nnikolov3/ECE411/Layout and Schematics/Layout/ECE_411_project_B.png

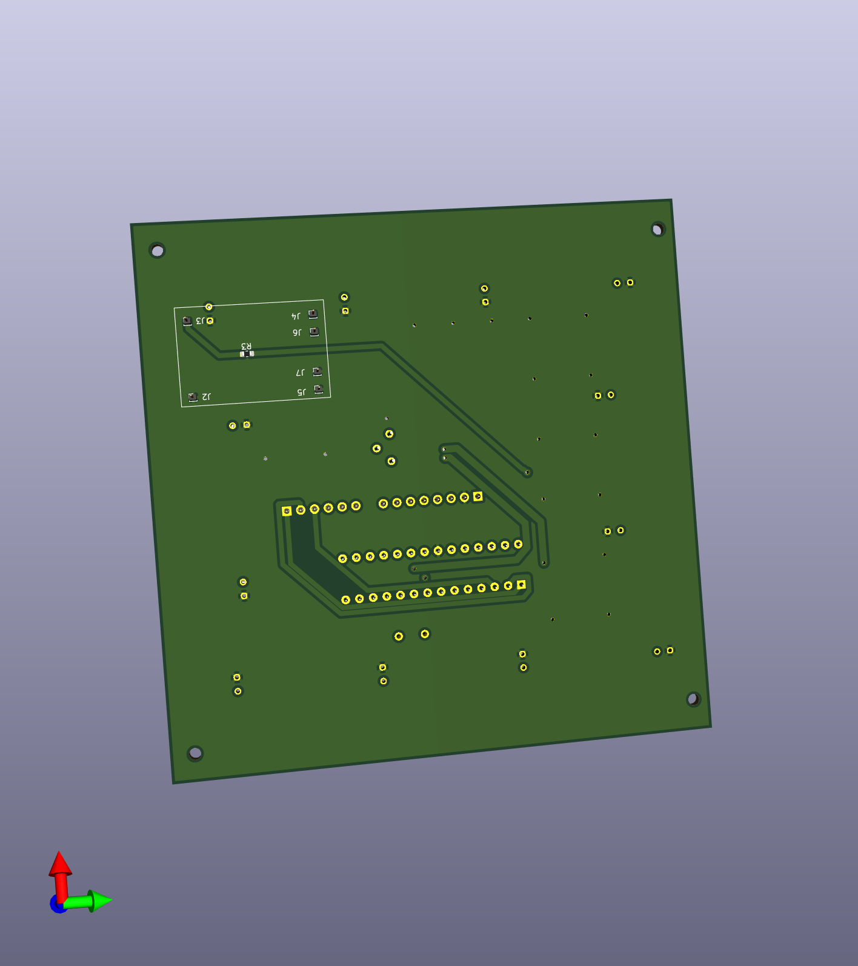
Layout and Schematics/Layout/ECE_411_project_B.png
