nnikolov3/ECE411/Pictures_and_Videos/testing_illumination/test_brightness.jpg

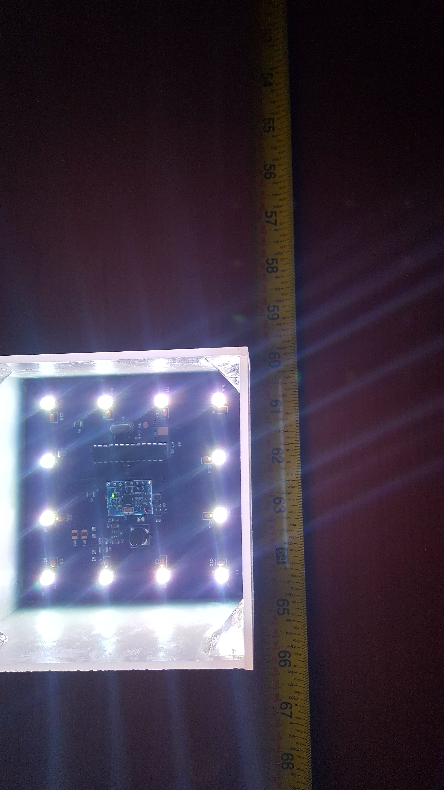
Pictures_and_Videos/testing_illumination/test_brightness.jpg
