nnikolov3/ECE411/Layout and Schematics/Layout/DRC_APPROVED_errors.png

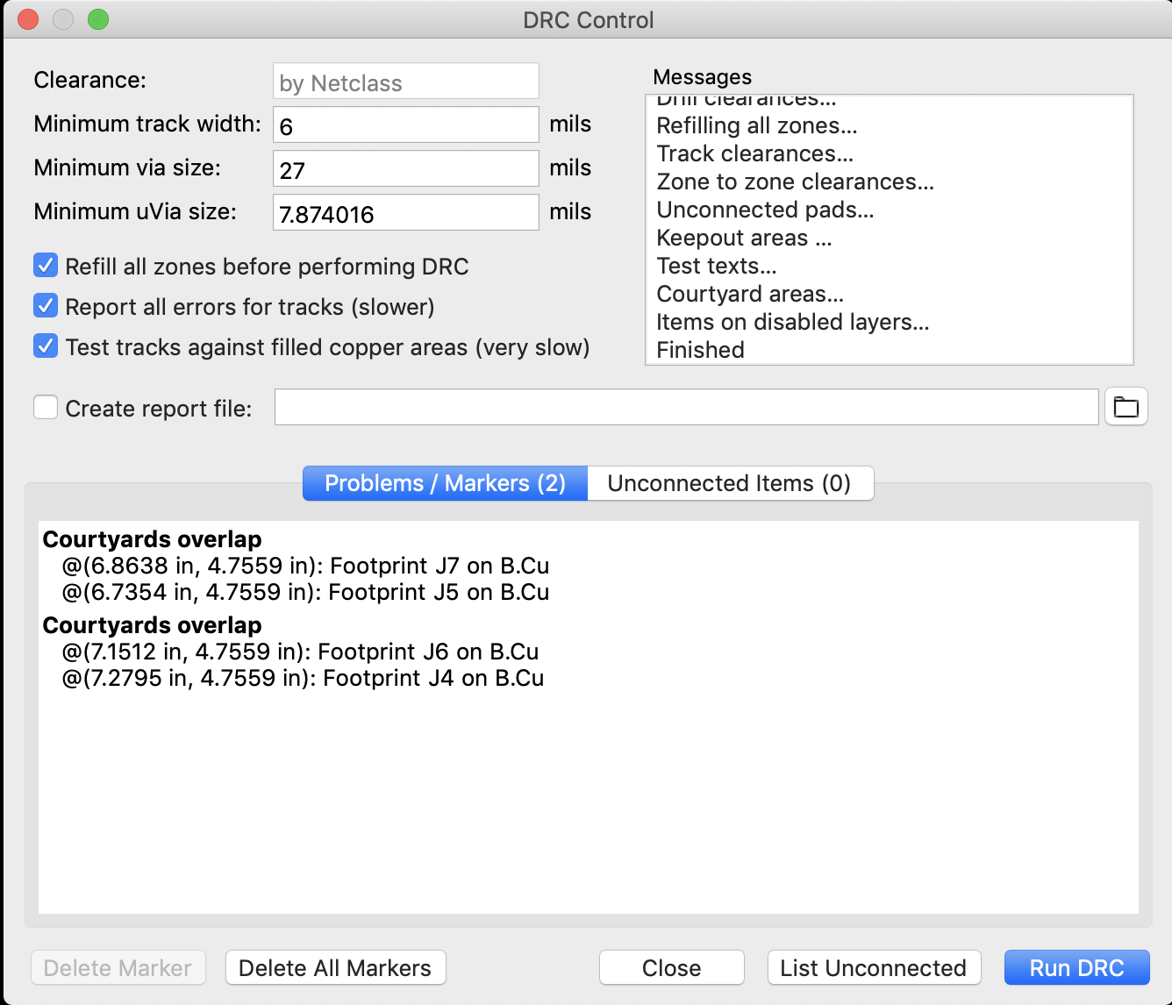
Layout and Schematics/Layout/DRC_APPROVED_errors.png
