nnikolov3/ECE411/Layout and Schematics/Layout/DRC_CLEARED.png

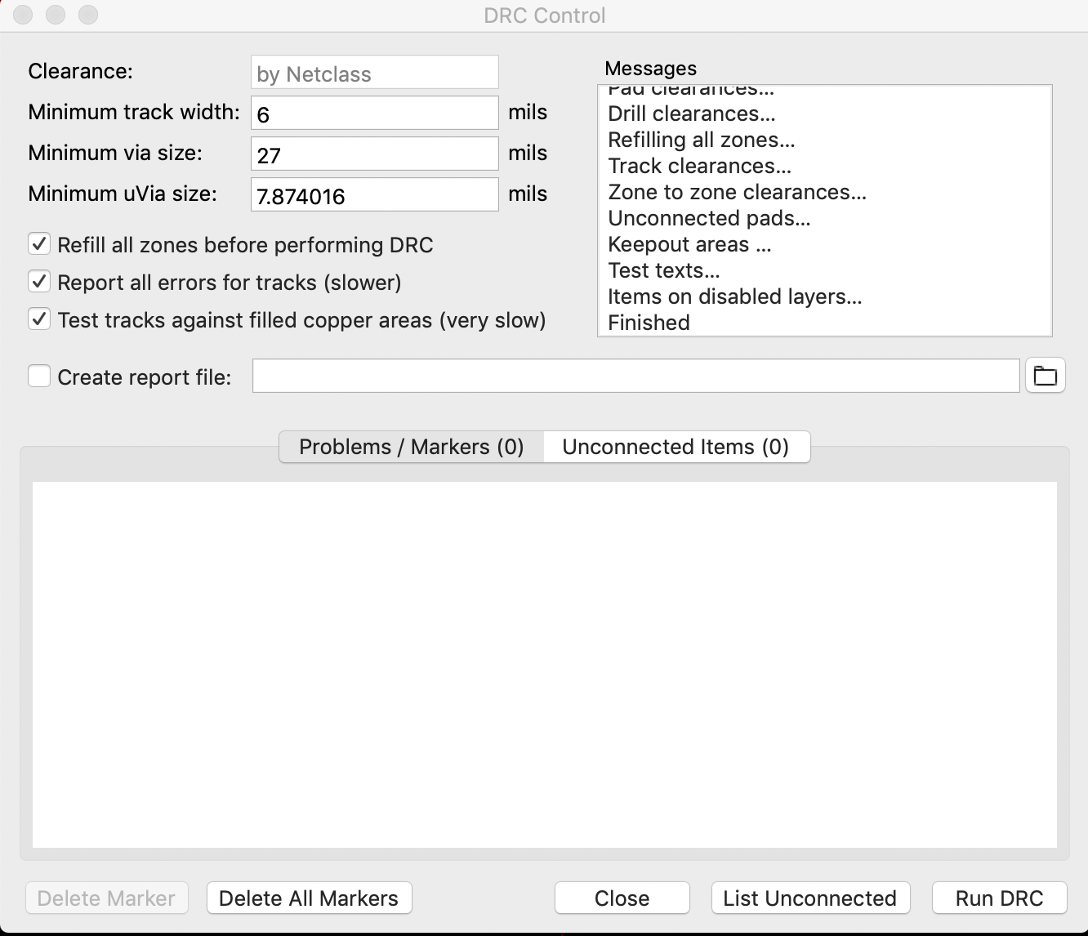
Layout and Schematics/Layout/DRC_CLEARED.png
