nnikolov3/ECE411/Layout and Schematics/Layout/ECE_411_project 2.png

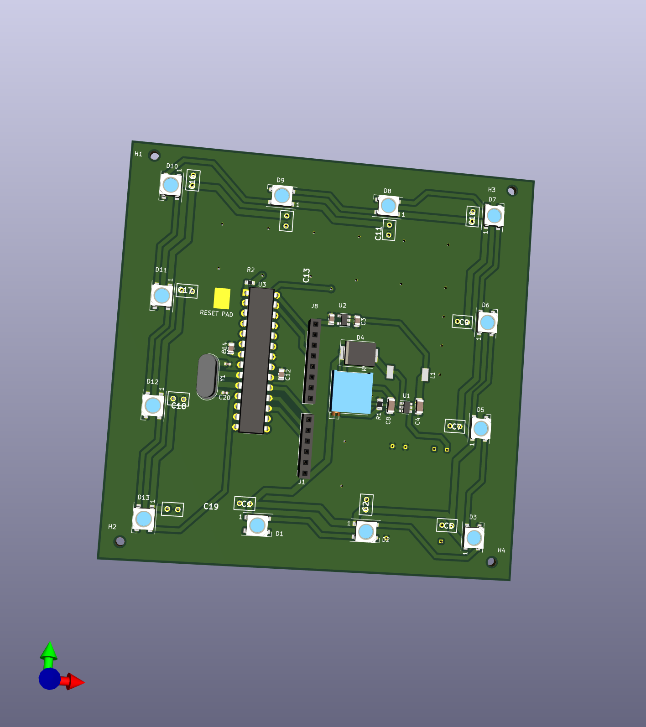
Layout and Schematics/Layout/ECE_411_project 2.png
