nnikolov3/ECE411/Layout and Schematics/Layout/ECE_411_project_3d_front.jpg

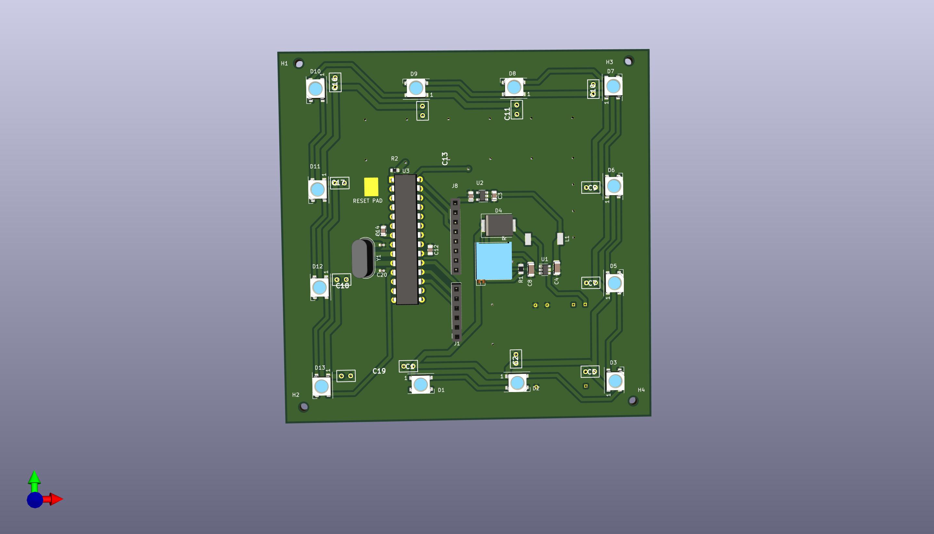
Layout and Schematics/Layout/ECE_411_project_3d_front.jpg
