nnikolov3/ECE411/Layout and Schematics/Layout/ERC_APPROVED_warning.png

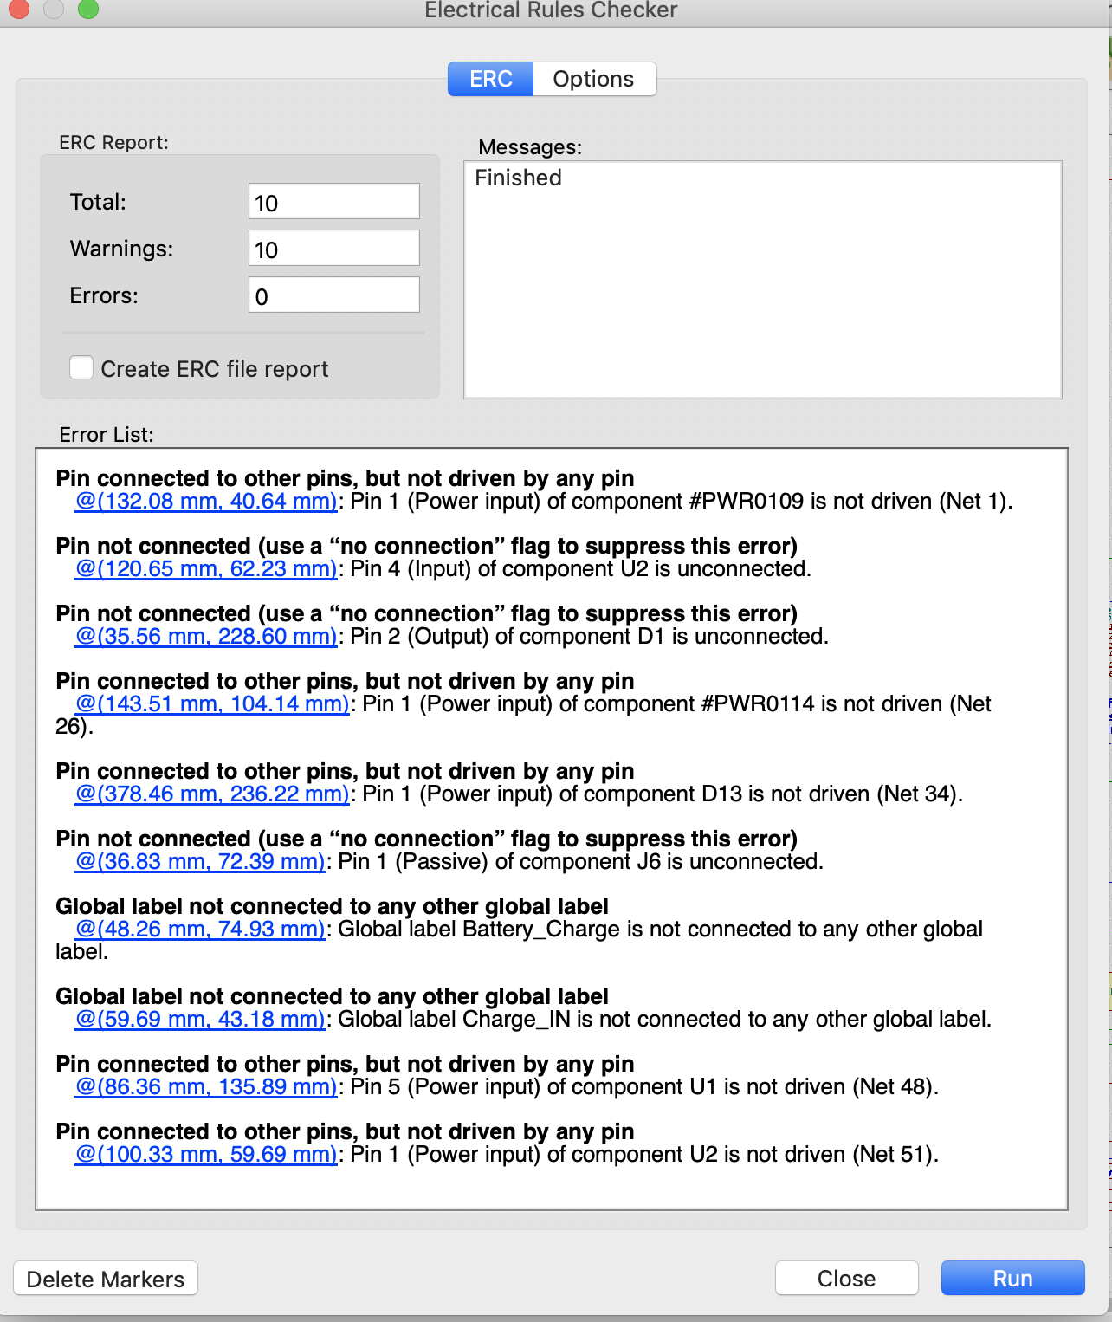
Layout and Schematics/Layout/ERC_APPROVED_warning.png
