nnikolov3/ECE411/Layout and Schematics/Schematics/ECE_411_project.png

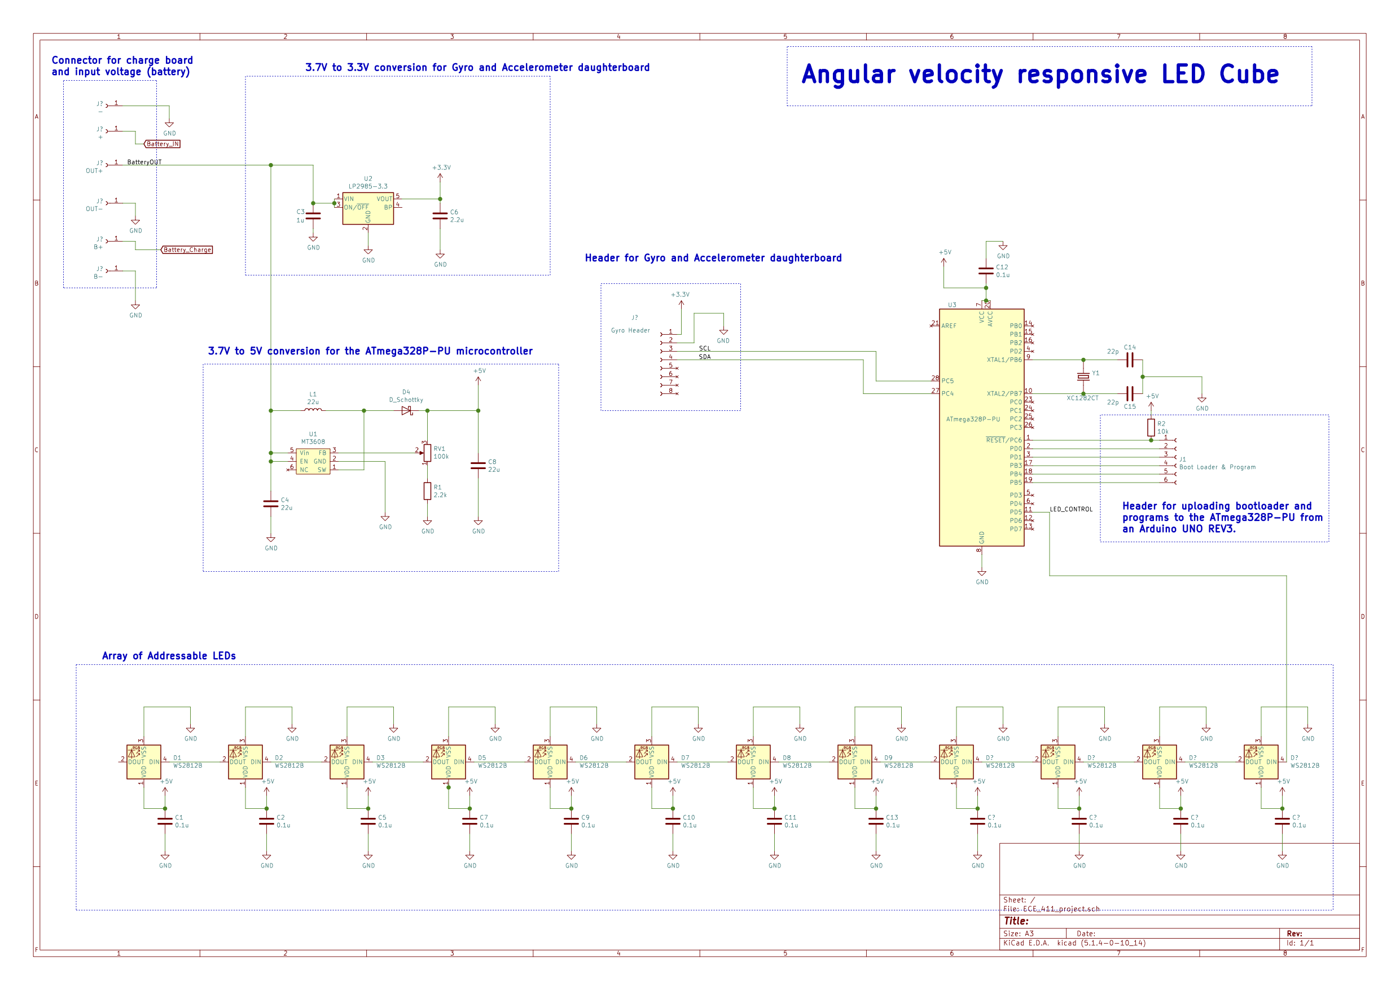
Layout and Schematics/Schematics/ECE_411_project.png
