nnikolov3/ECE411/Mechanical/charge stand bottom view.png

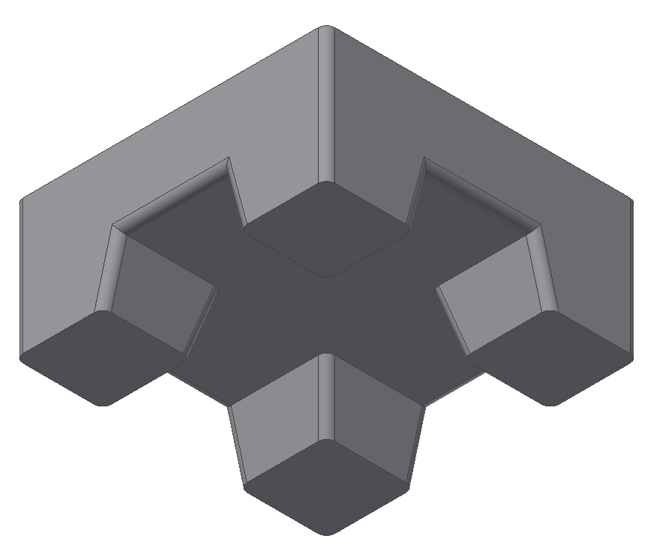
Mechanical/charge stand bottom view.png
