nnikolov3/ECE411/Mechanical/charge stand top view.png

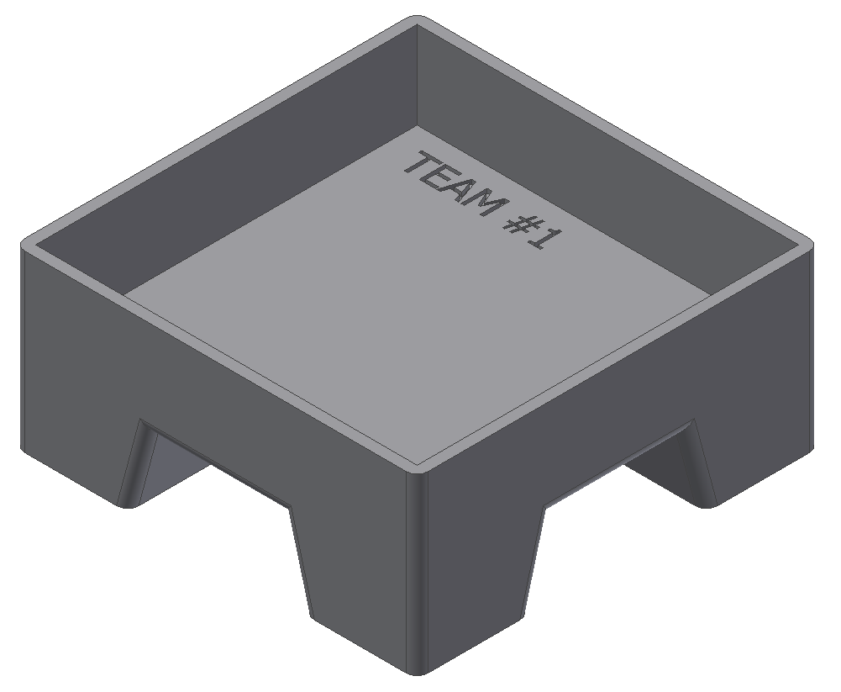
Mechanical/charge stand top view.png
