nnikolov3/ECE411/Mechanical/cube charging station.png

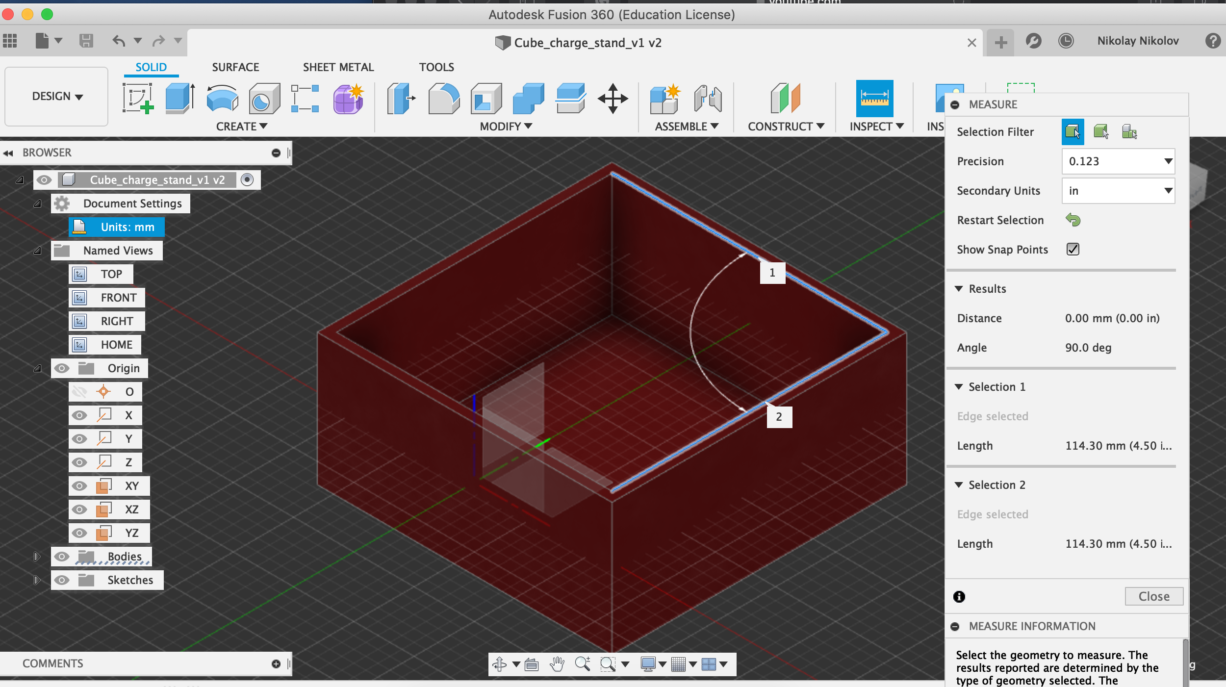
Mechanical/cube charging station.png
