nnikolov3/ECE411/Pictures_and_Videos/20191021_190228.jpg

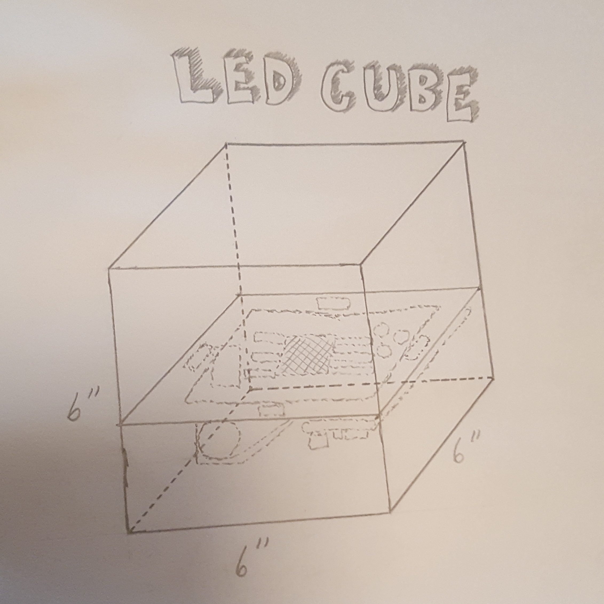
Pictures_and_Videos/20191021_190228.jpg
