nnikolov3/ECE411/Pictures_and_Videos/20191021_190235.jpg

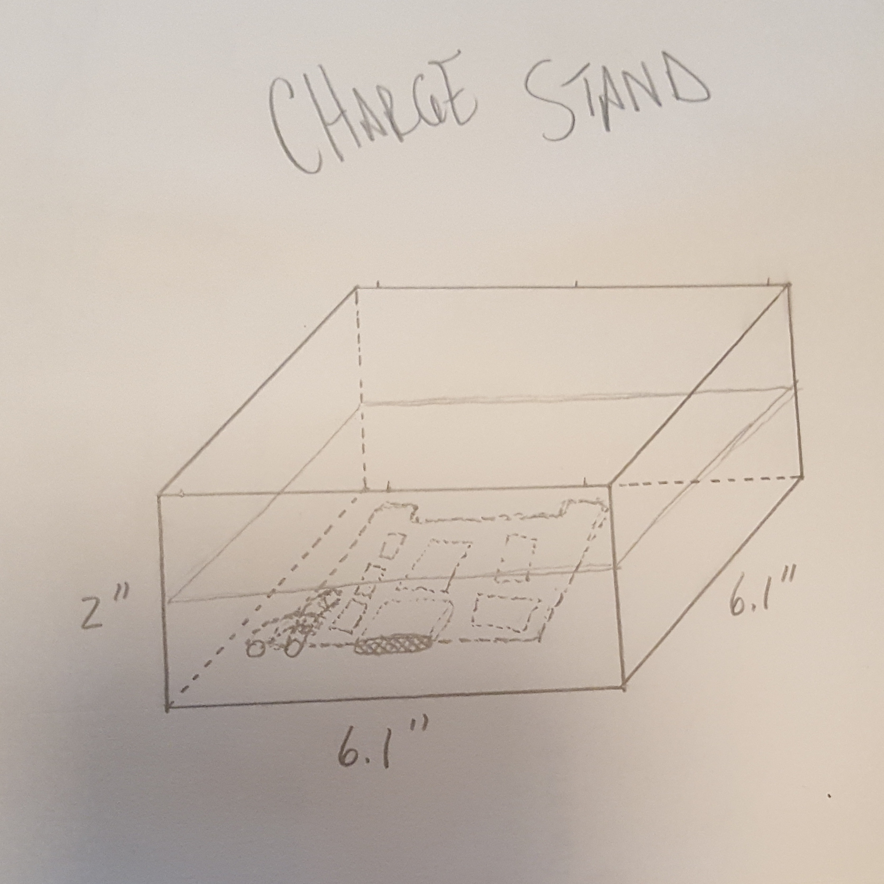
Pictures_and_Videos/20191021_190235.jpg
