nnikolov3/ECE411/Pictures_and_Videos/20191030_160920.jpg

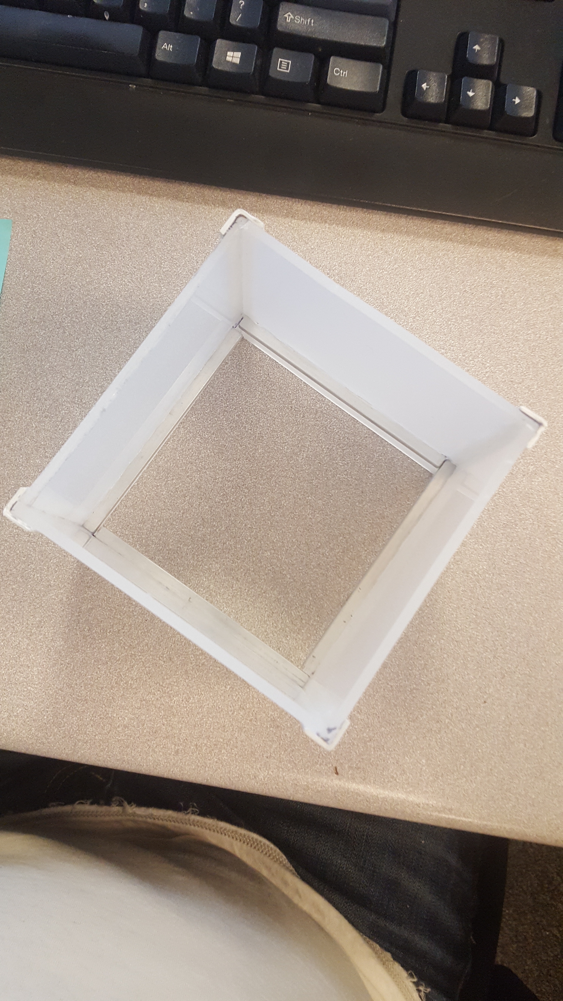
Pictures_and_Videos/20191030_160920.jpg
