nnikolov3/ECE411/Pictures_and_Videos/20191030_161455.jpg

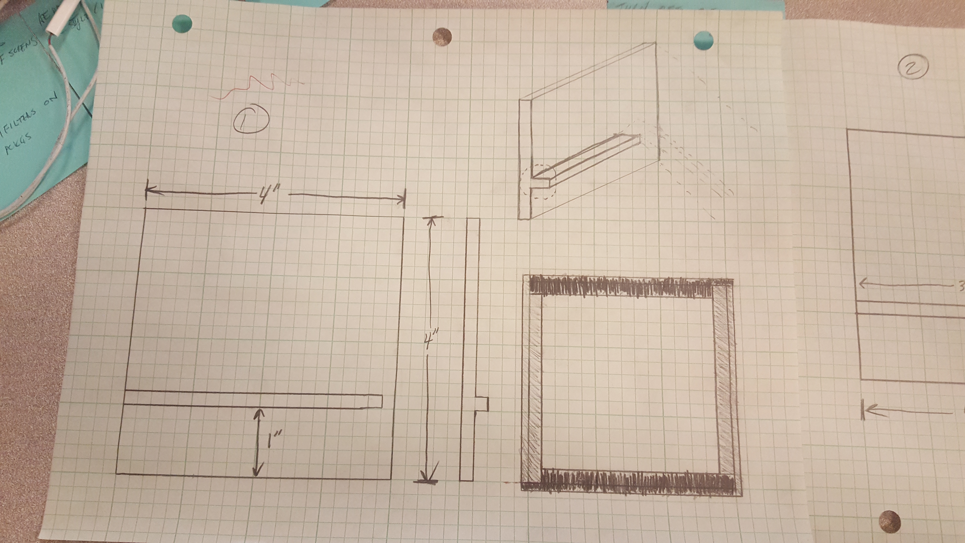
Pictures_and_Videos/20191030_161455.jpg
