nnikolov3/ECE411/Pictures_and_Videos/20191030_161500.jpg

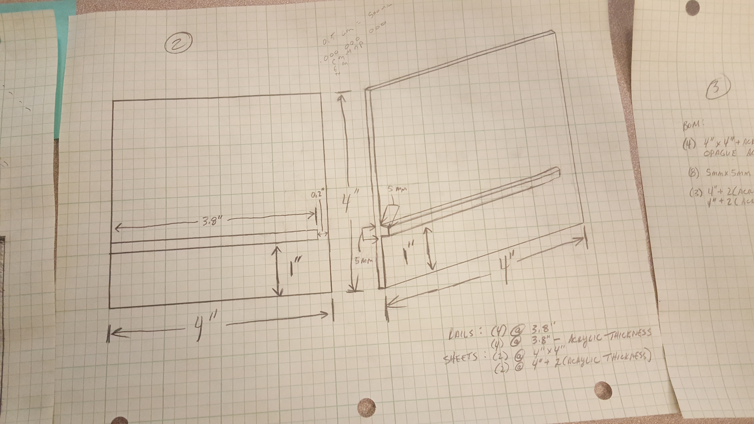
Pictures_and_Videos/20191030_161500.jpg
