nnikolov3/ECE411/Pictures_and_Videos/20191105_185958.jpg

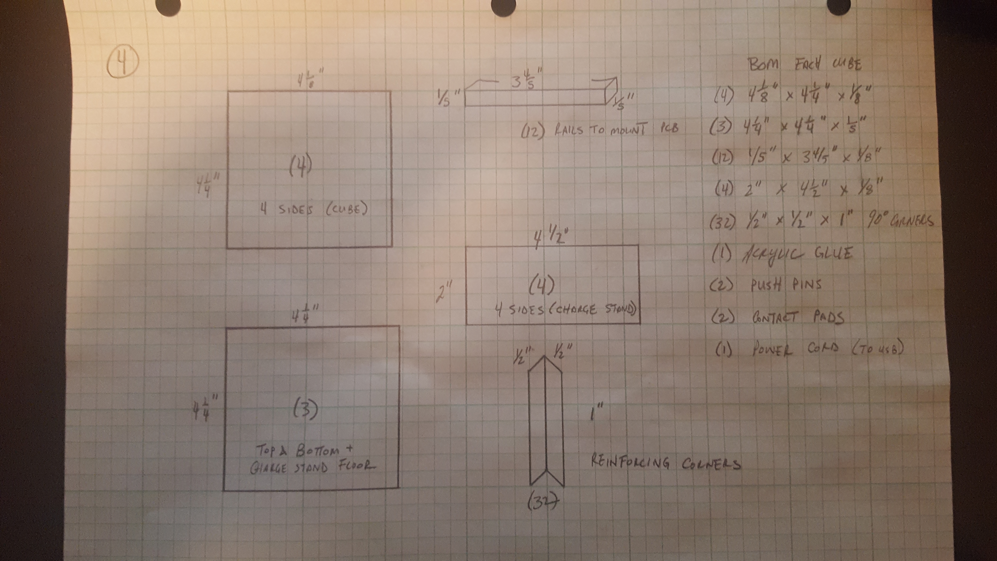
Pictures_and_Videos/20191105_185958.jpg
