nnikolov3/ECE411/Pictures_and_Videos/20191119_073626.jpg

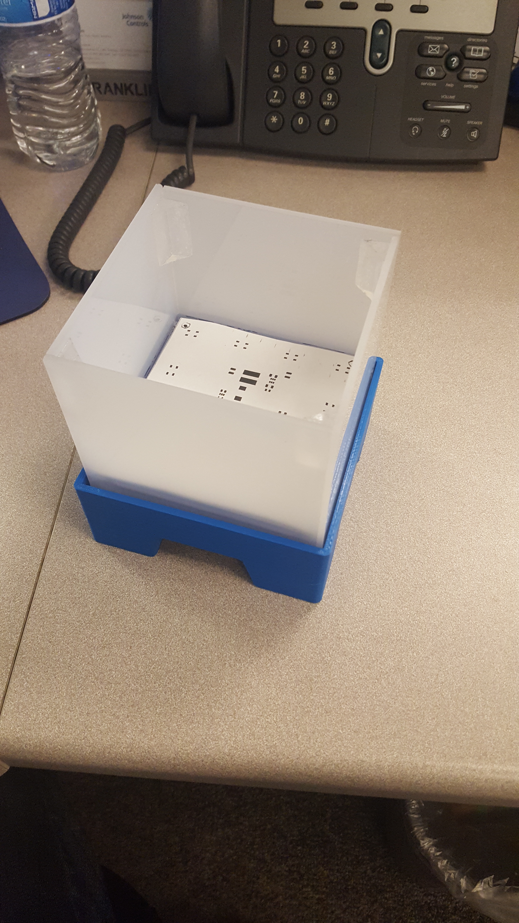
Pictures_and_Videos/20191119_073626.jpg
