nnikolov3/ECE411/Pictures_and_Videos/complete_prototype/LED_Cube_complete_prototype.jpg

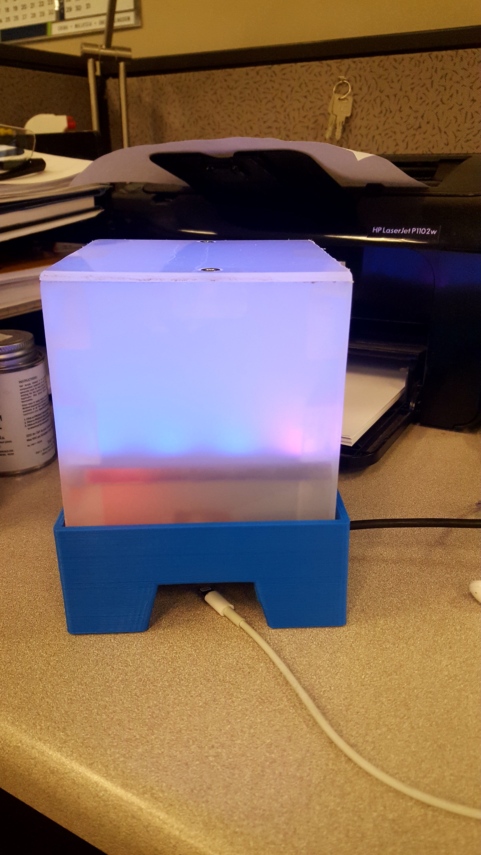
Pictures_and_Videos/complete_prototype/LED_Cube_complete_prototype.jpg
