nnikolov3/ECE411/Pictures_and_Videos/cube_doc_charging_station/20191121_145219.jpg

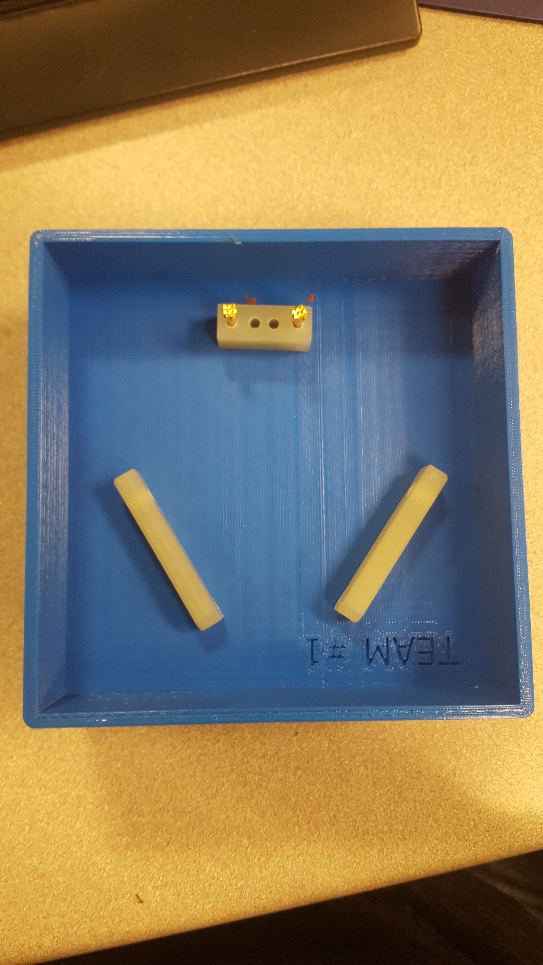
Pictures_and_Videos/cube_doc_charging_station/20191121_145219.jpg
