nnikolov3/ECE411/Pictures_and_Videos/ECE_411_project.jpg

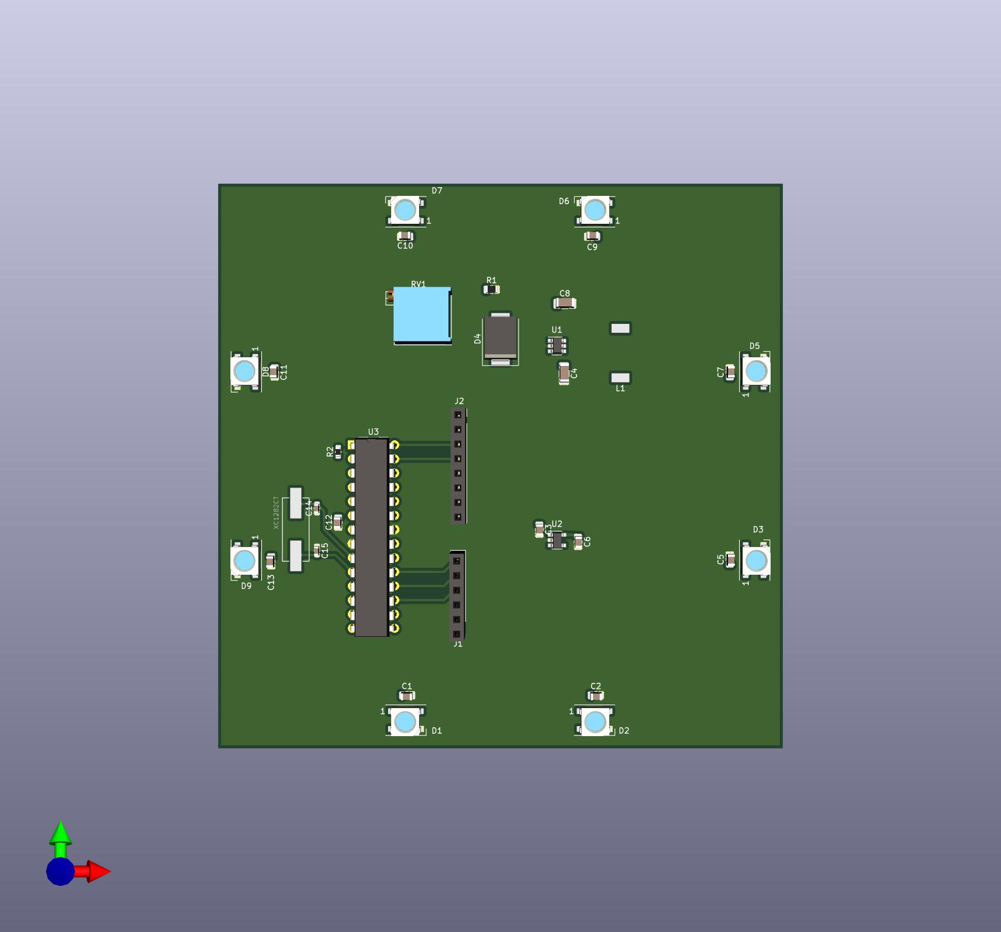
Pictures_and_Videos/ECE_411_project.jpg
