nnikolov3/ECE411/Pictures_and_Videos/gant_chart2.jpg

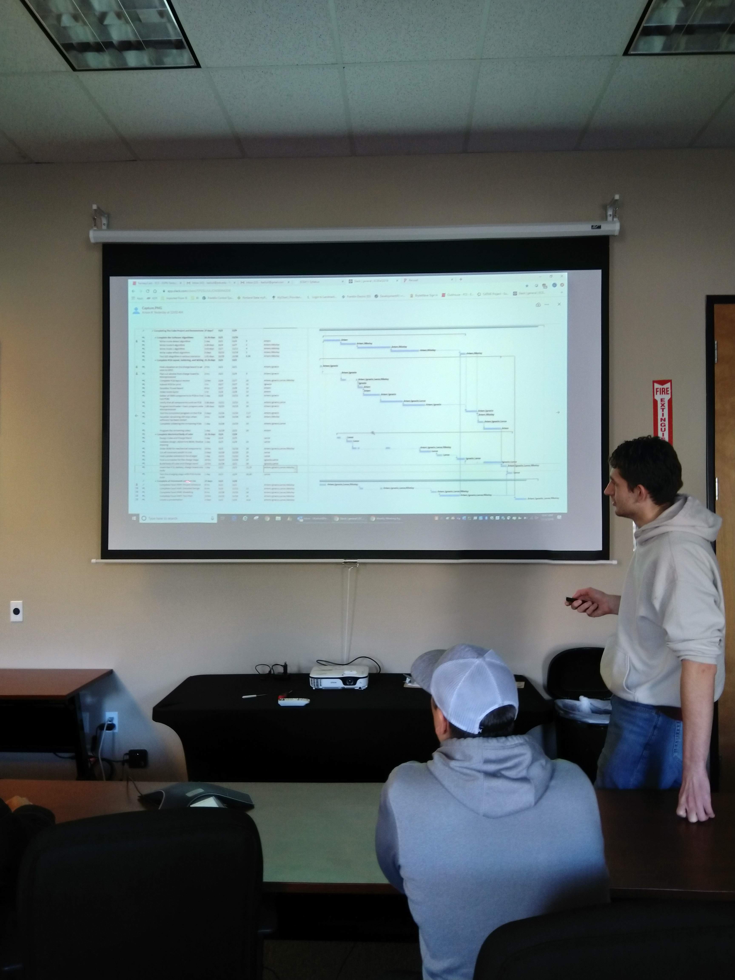
Pictures_and_Videos/gant_chart2.jpg
