nnikolov3/ECE411/Pictures_and_Videos/gantt_chart.jpg

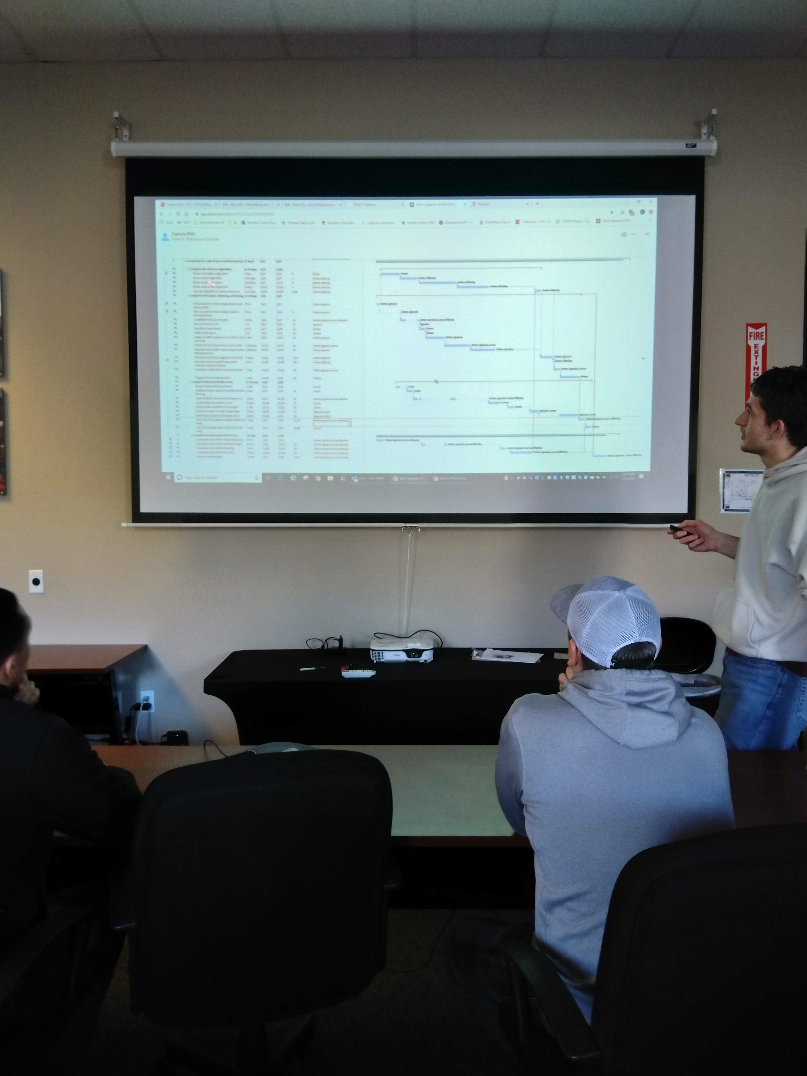
Pictures_and_Videos/gantt_chart.jpg
