nnikolov3/ECE411/Pictures_and_Videos/Gantt_Chart.PNG

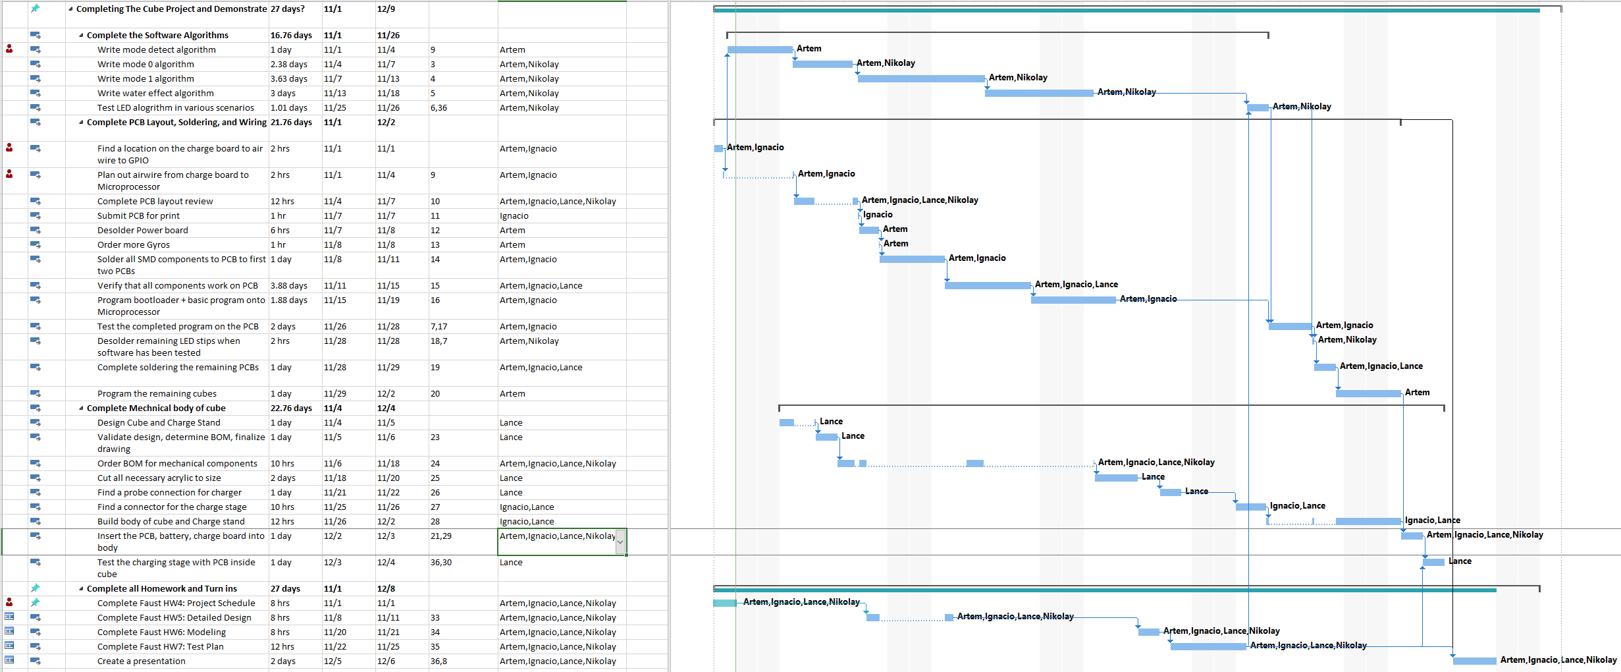
Pictures_and_Videos/Gantt_Chart.PNG
