nnikolov3/ECE411/Pictures_and_Videos/img_20191016_092339-2.jpg

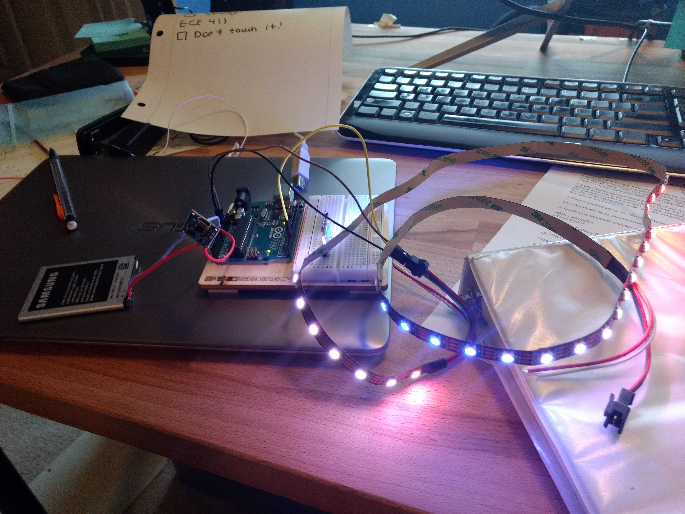
Pictures_and_Videos/img_20191016_092339-2.jpg
