nnikolov3/ECE411/Pictures_and_Videos/IMG_20191020_131746.jpg

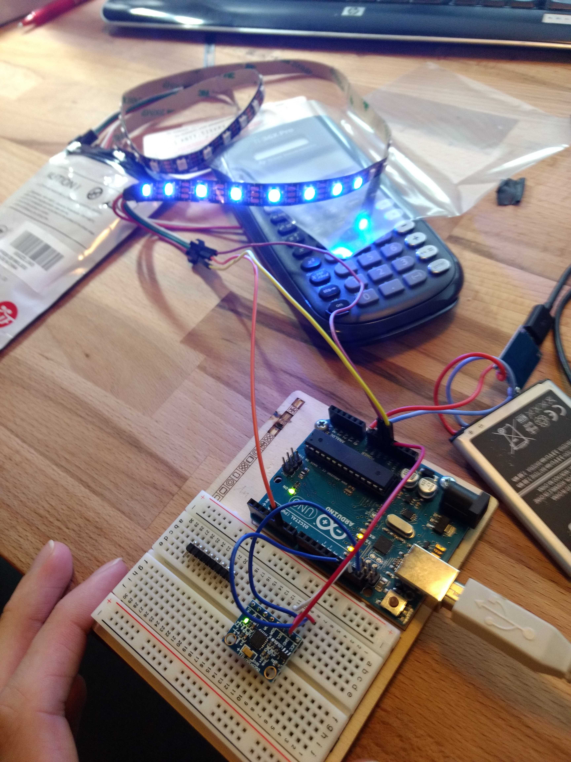
Pictures_and_Videos/IMG_20191020_131746.jpg
