nnikolov3/ECE411/Pictures_and_Videos/IMG_20191027_100446.jpg

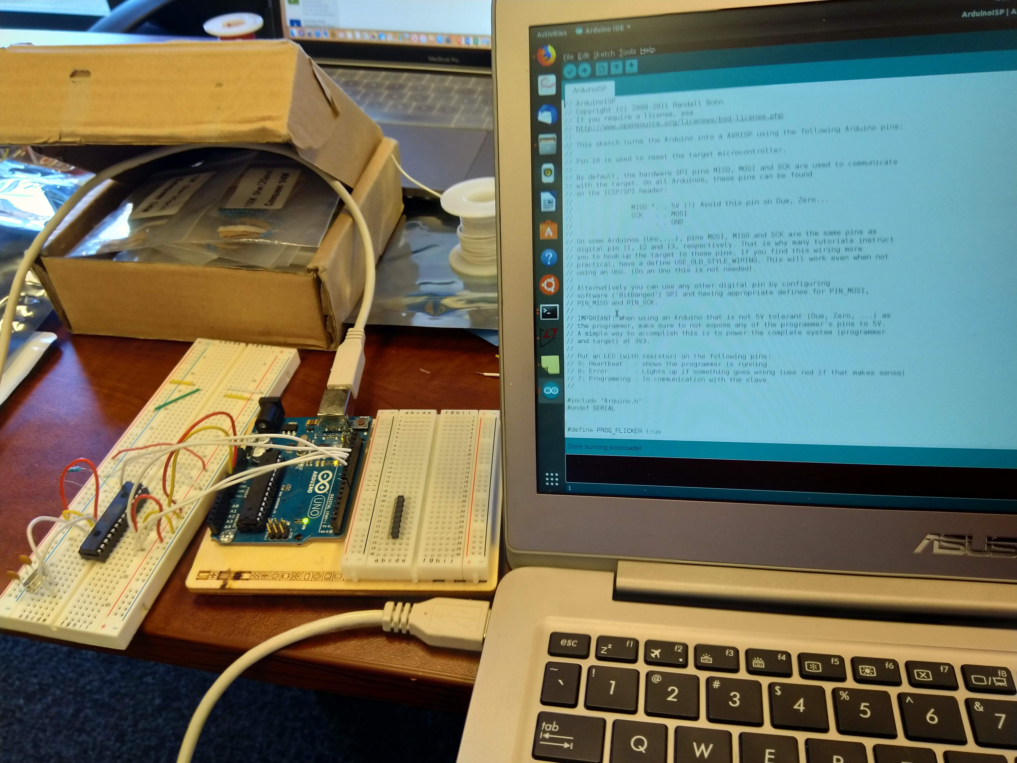
Pictures_and_Videos/IMG_20191027_100446.jpg
