nnikolov3/ECE411/Pictures_and_Videos/IMG_20191027_100500.jpg

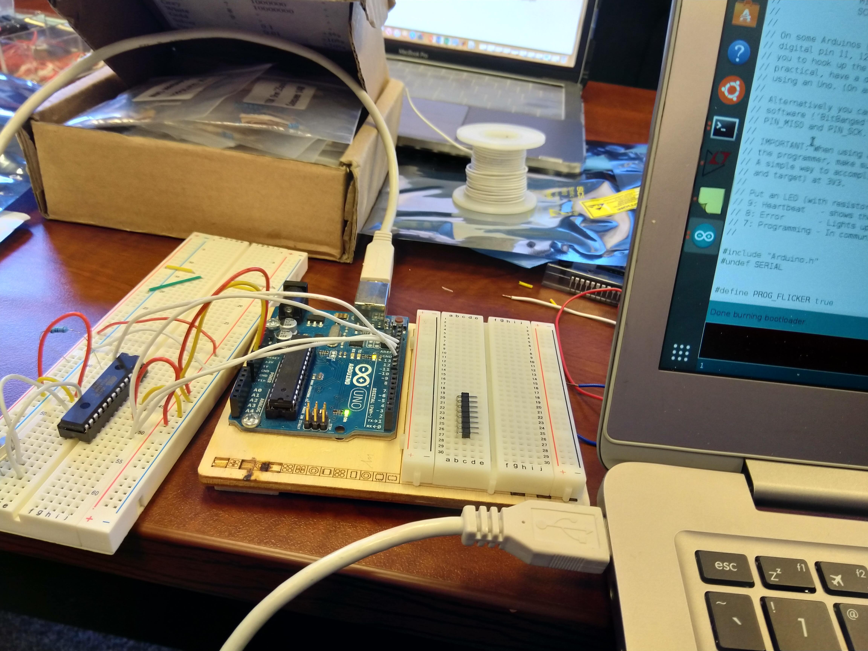
Pictures_and_Videos/IMG_20191027_100500.jpg
