nnikolov3/ECE411/Pictures_and_Videos/IMG_20191110_115041.jpg

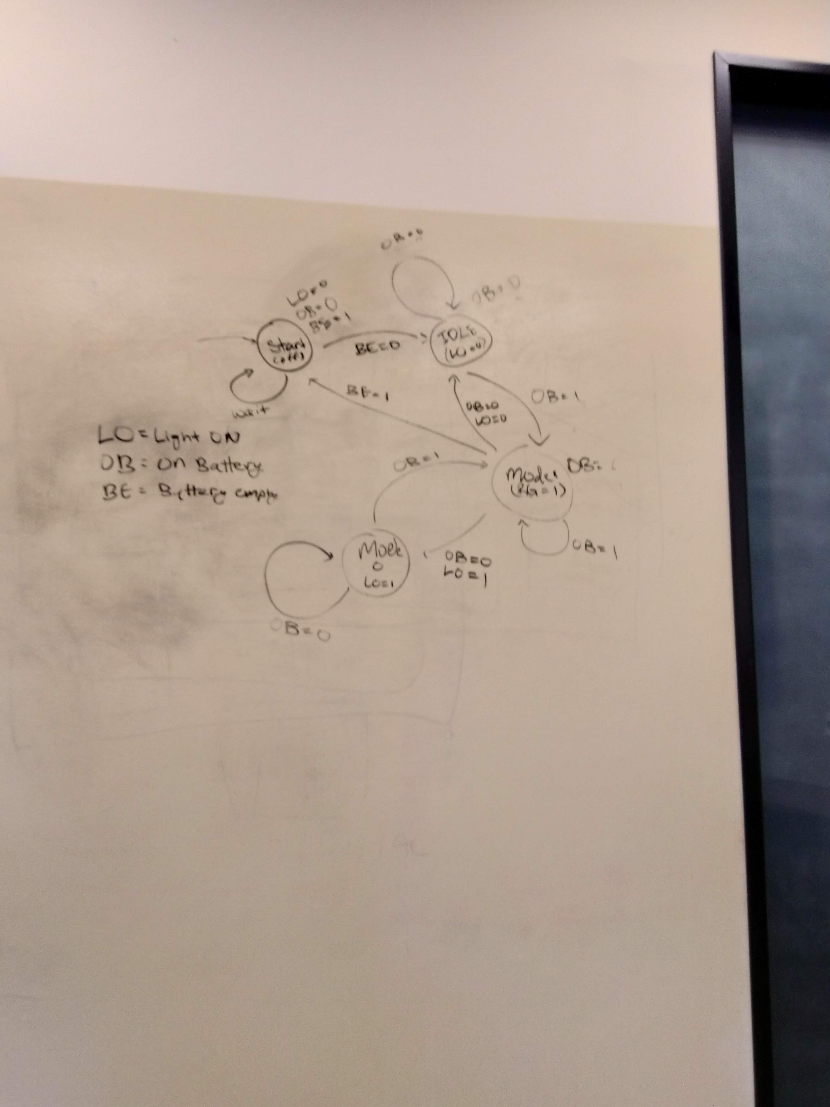
Pictures_and_Videos/IMG_20191110_115041.jpg
