nnikolov3/ECE411/Pictures_and_Videos/meeting_11_10/artem_battery_supply_3.jpg

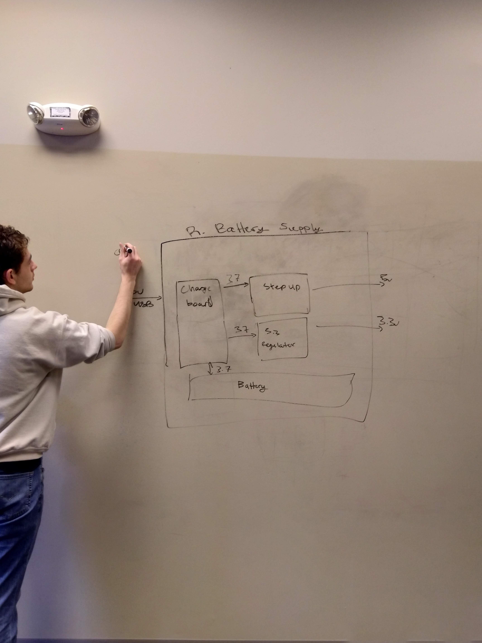
Pictures_and_Videos/meeting_11_10/artem_battery_supply_3.jpg
