nnikolov3/ECE411/Pictures_and_Videos/meeting_11_10/led_mode_1_state_diagram.jpg

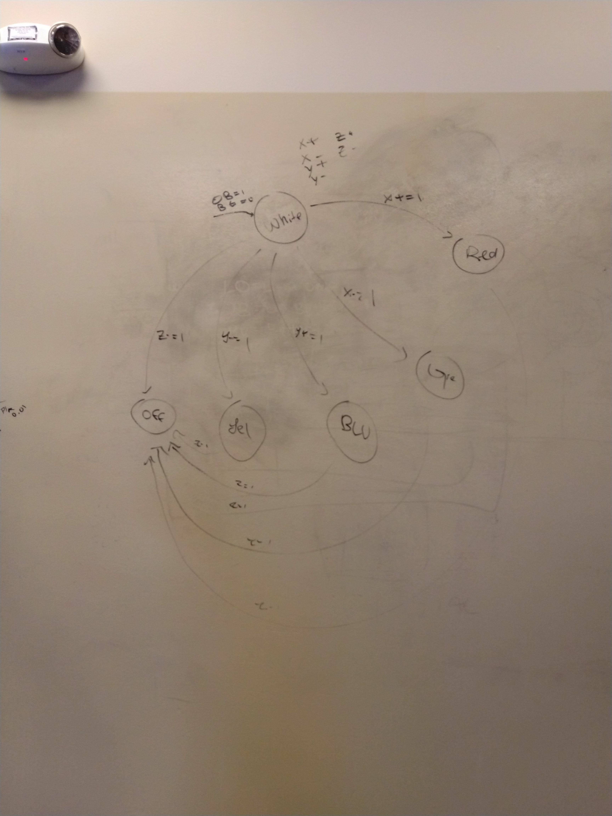
Pictures_and_Videos/meeting_11_10/led_mode_1_state_diagram.jpg
