nnikolov3/ECE411/Pictures_and_Videos/meeting_11_10/led_state_diagram_2.jpg

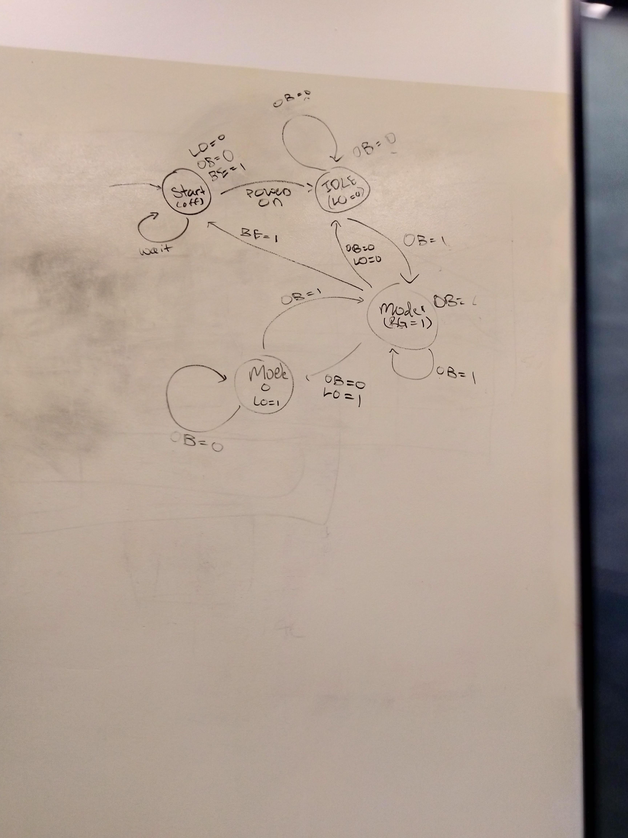
Pictures_and_Videos/meeting_11_10/led_state_diagram_2.jpg
