nnikolov3/ECE411/Pictures_and_Videos/meeting_11_10/light_cube_level_0_development.jpg

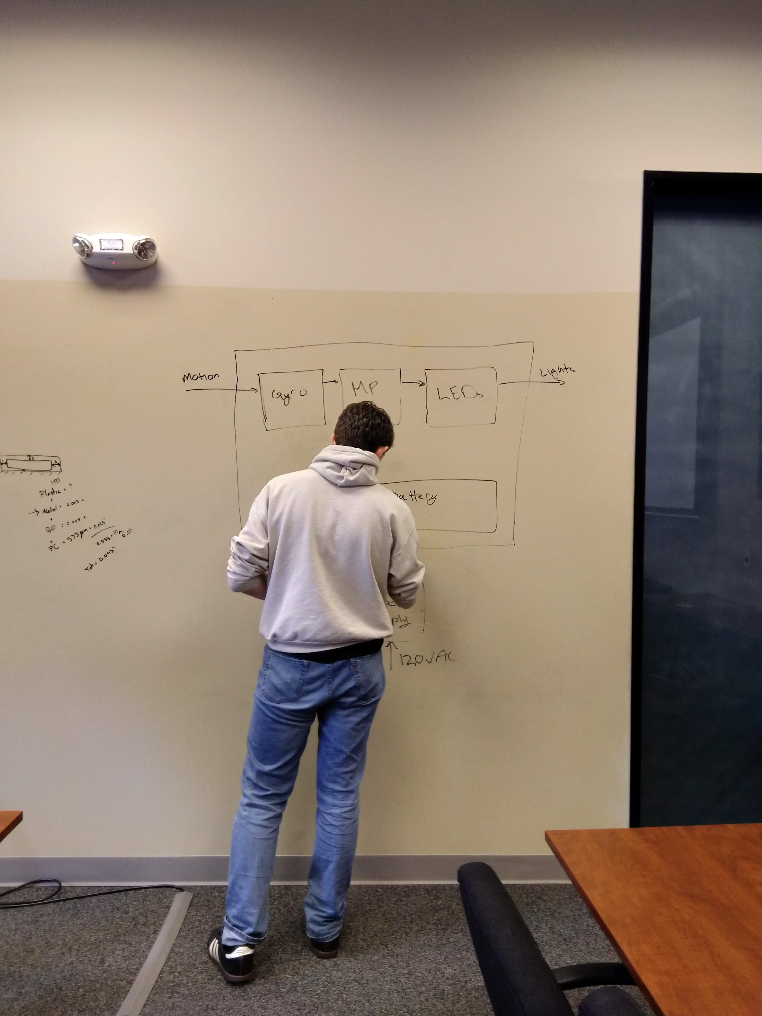
Pictures_and_Videos/meeting_11_10/light_cube_level_0_development.jpg
