nnikolov3/ECE411/Pictures_and_Videos/Requirements.png

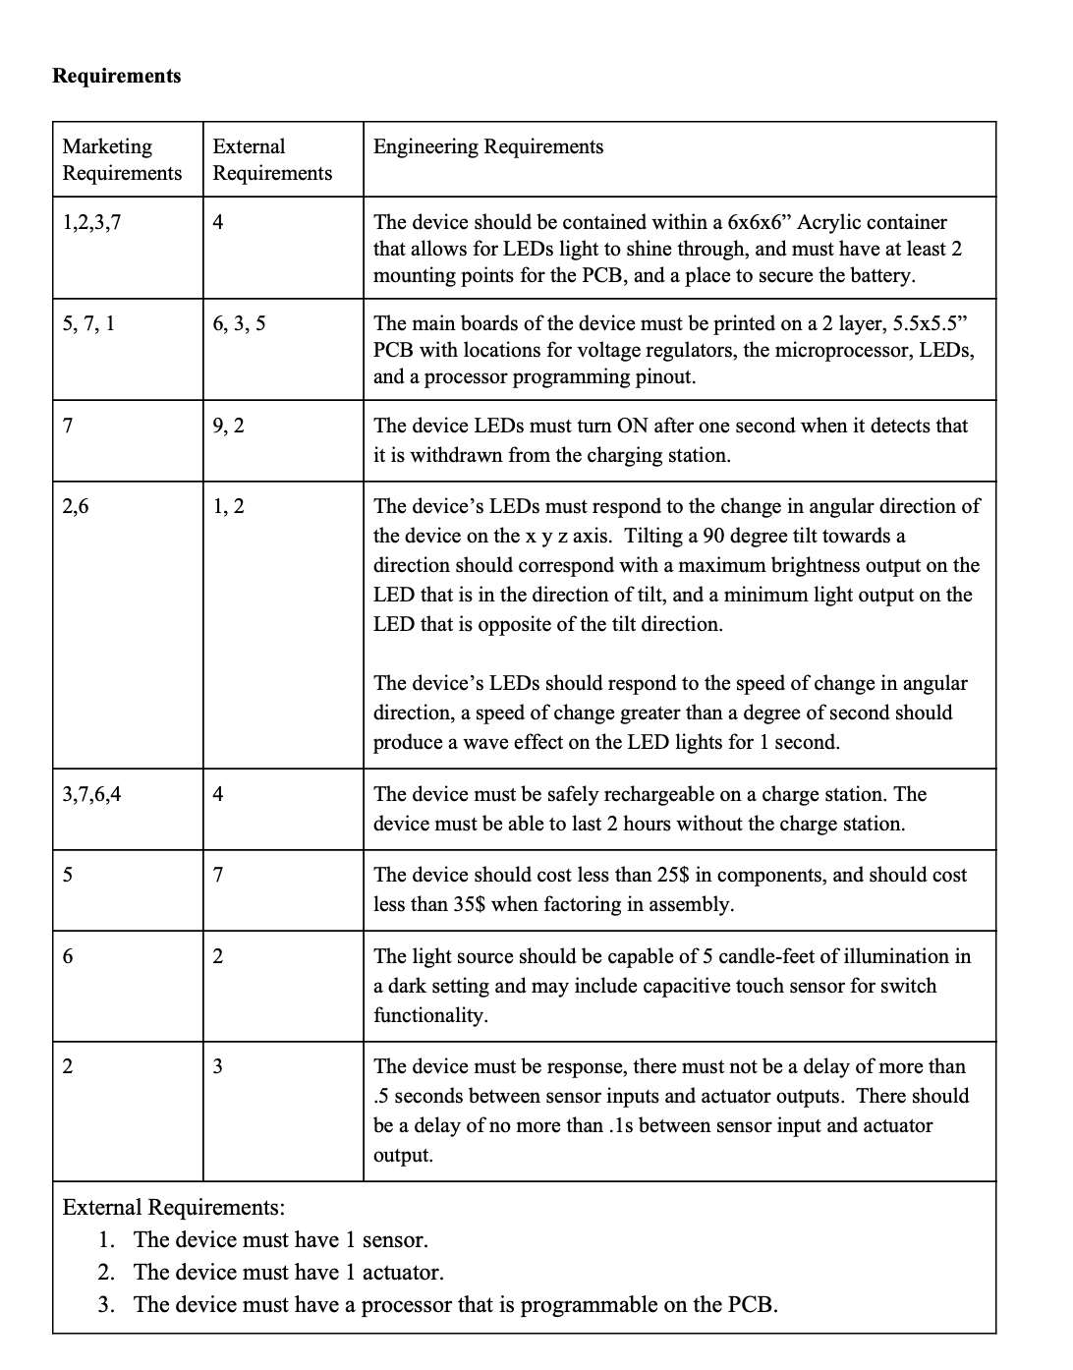
Pictures_and_Videos/Requirements.png
