nnikolov3/ECE411/Project_management/project plan rev3.PNG

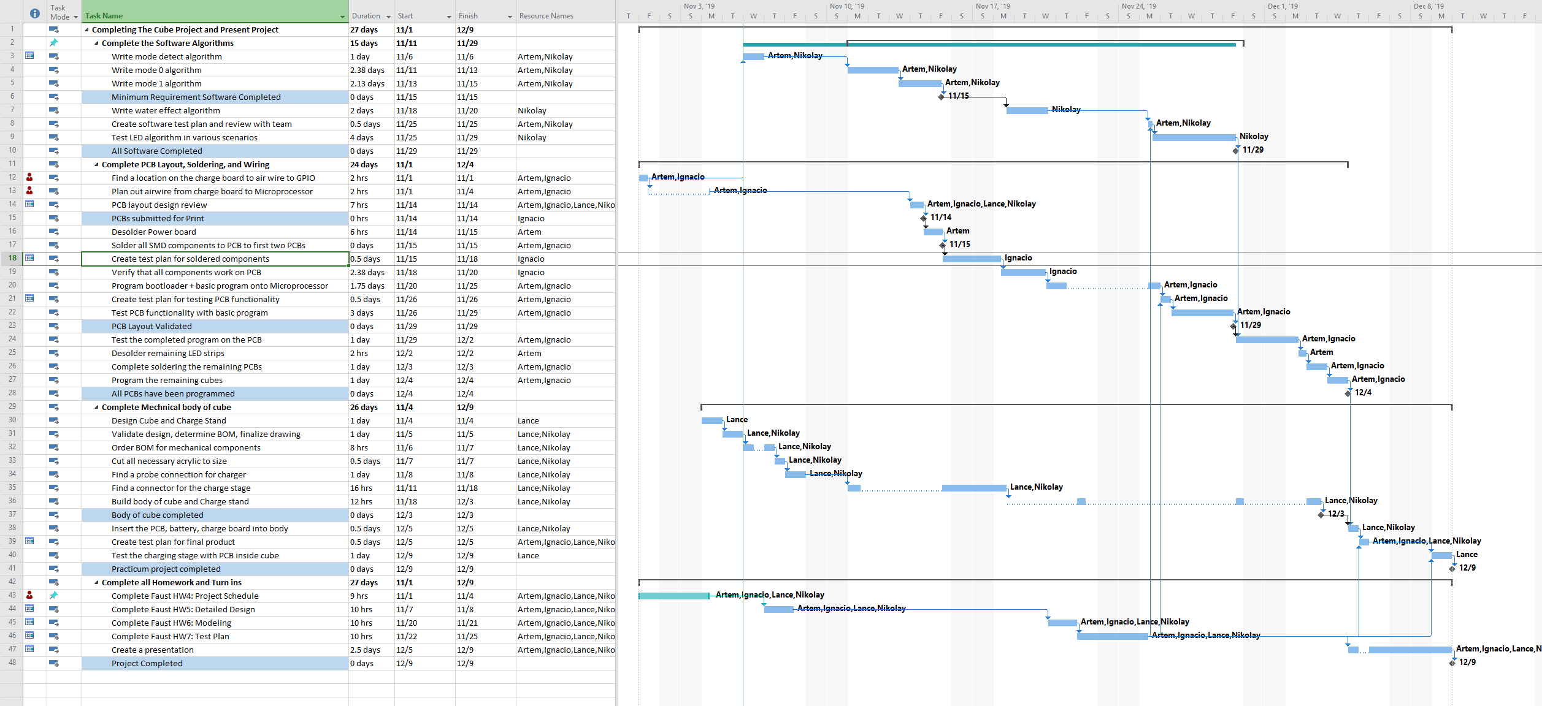
Project_management/project plan rev3.PNG
