nnikolov3/ECE411/Orders and BOM/ECE411_BOM_with_meeting_notes.xlsx

REFERENCE | QUANTITY (per board) | VALUE | P/N | Price (per part) | Price (per board) | Minimum (no extra parts) price for 4 board) | Notes: | Description
C13 C11 C10 C9 C7 C5 C2 C1 C12 C16 C17 C18 C19 C14 | 14 | 0.1u | 80-C0805X104K4RAUTO | $0.68 | $9.52 | $38.08 | Check EPL, Check at home, use through holes
C4 C8 | 2 | 22u | 581-12063D226KAT2A | $1.15 | $2.30 | $9.20 | re use the one on the board, change the size for the schematic
R2 | 1 | 10k | 660-RN73R1JTD1002B50 | $0.59 | $0.59 | $2.36 | wait on that
D4 | 1 | D_shottky | 512-SS34 | $0.45 | $0.45 | $1.80 | use the one from the boost converter the 3296
R1 | 1 | 2.2k | 594-MCU08050C2201FP5 | $0.31 | $0.31 | $1.24 | order that
C3 | 1 | 1u | 581-08056C105JAZ2A | $1.98 | $1.98 | $7.92 | order that
C6 | 1 | 2.2u | 81-GCM21BR71A225JA7L | $0.42 | $0.42 | $1.68 | order that
U1 | 1 | MT3608 | N/A | Already Have
L1 | 1 | 22u | N/A | already Have
RV1 | 1 | 100k | N/A | already Have
U3 | 1 | ATmega328P-PU | N/A | already Have
D9 D8 D7 D6 D5 D3 D2 D1 D10 D11 D12 D13 | 12 | WS2812B | N/A | already Have
Y1 | 1 | 9B-16.000MBBK-B | N/A | already Have
U2 | 1 | LP2985-3.3 | 296-18476-1-ND | $0.58 | $0.58 | $2.32 | order extra 2
J2,J3,J4,J5,J6,J7,J9 | 7 | Connectors | 3M156862-01-ND | $0.17 | $1.19 | $4.76 | order
C15 C20 | 2 | 22p | 732-7427-1-ND | $0.10 | $0.20 | $0.80 | order twice as many
J8 | 1 | Gyro Header | 9279 | $0.50 | $0.50 | $2.00
J1 | 1 | Boot Loader & Program | 9280 | $0.50 | $0.50 | $2.00
Total Price Per Board (Components we do not yet have) |  |  |  |  | $18.54 | $74.16
