nnikolov3/ECE411/Orders and BOM/Image from iOS.jpg

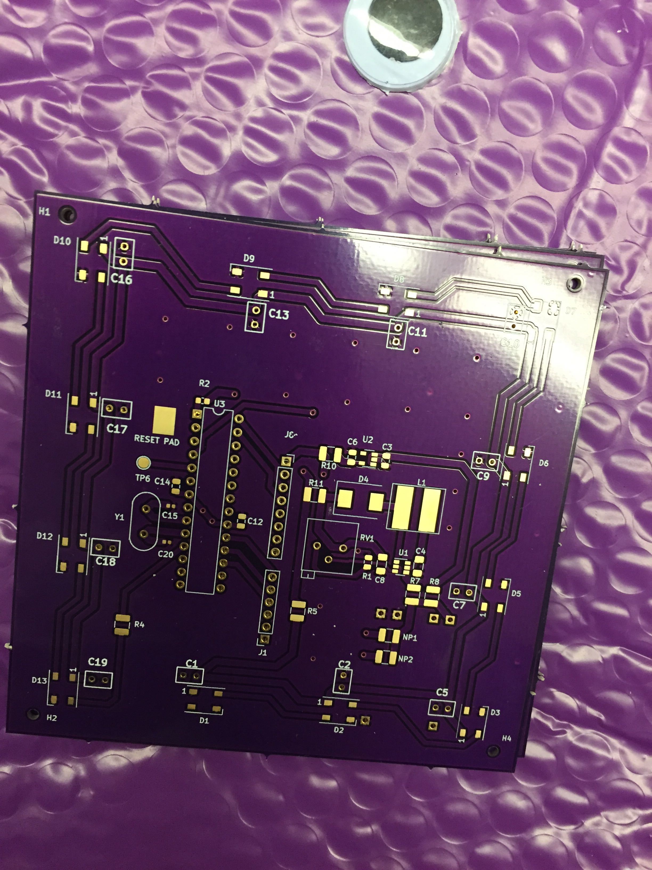
Orders and BOM/Image from iOS.jpg
