nnikolov3/ECE411/Orders and BOM/Order.png

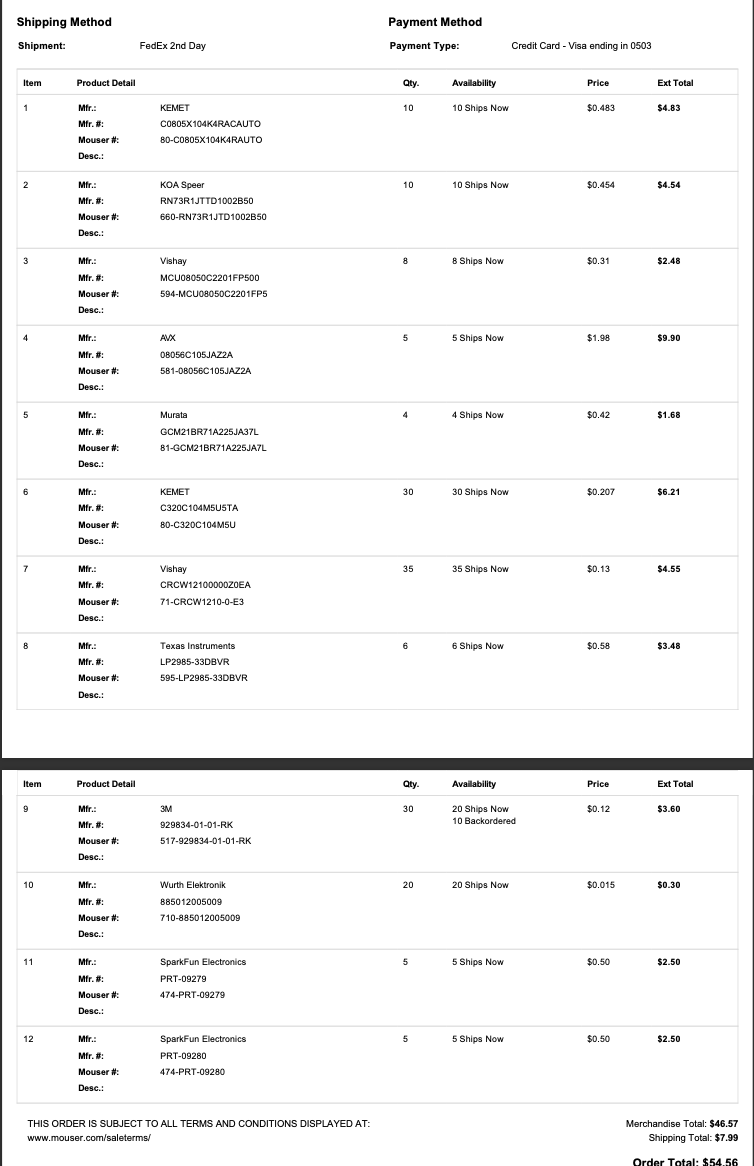
Orders and BOM/Order.png
