nnikolov3/ECE411/Orders and BOM/PCB_arrived1.jpg

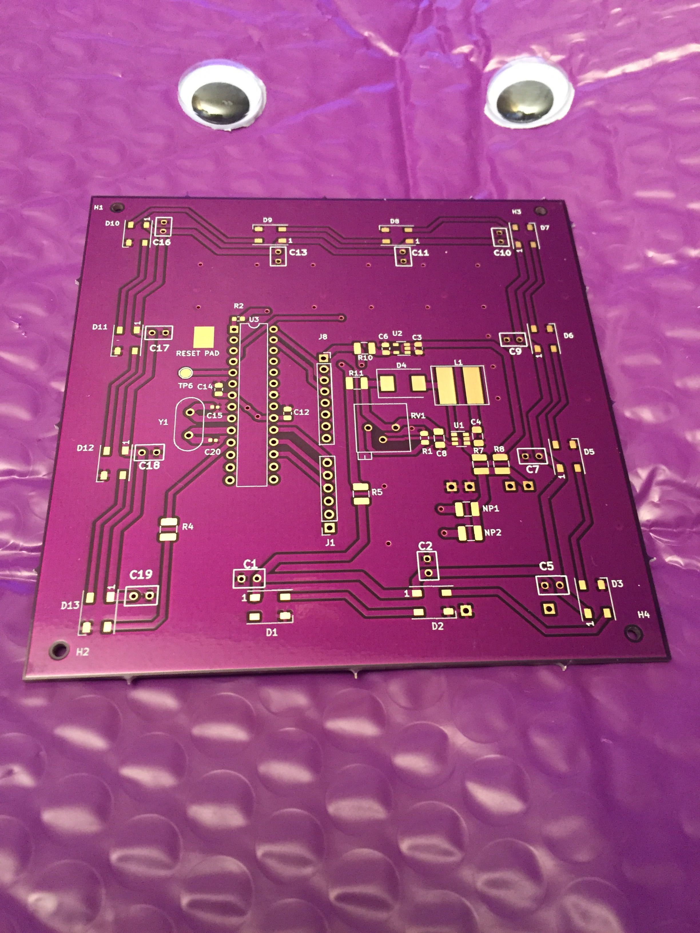
Orders and BOM/PCB_arrived1.jpg
