nnikolov3/ECE411/Orders and BOM/PCB_arrived2.jpg

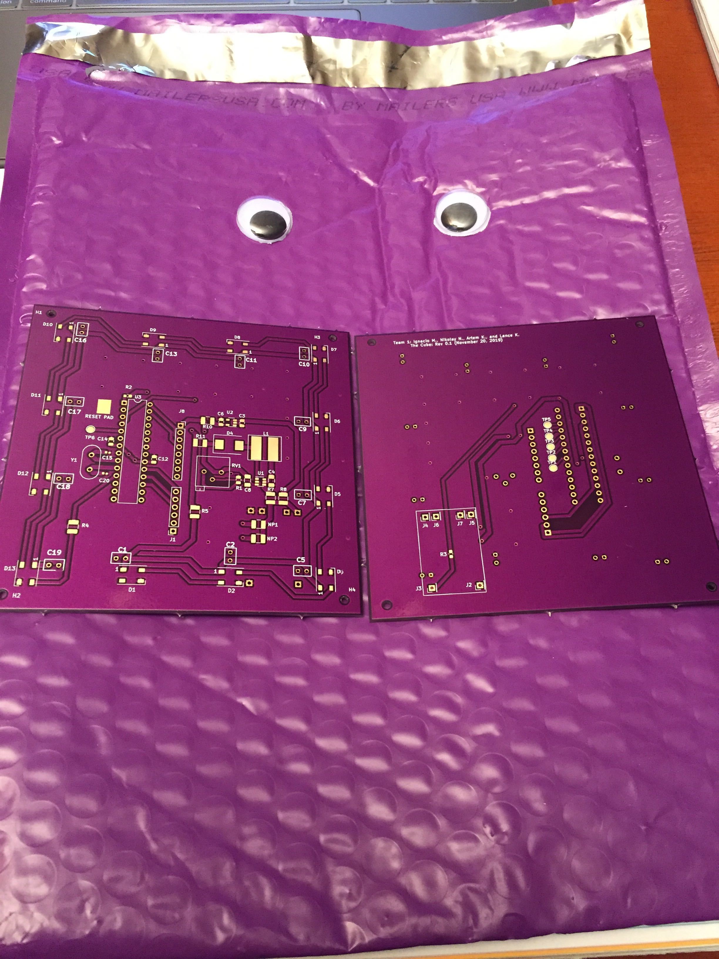
Orders and BOM/PCB_arrived2.jpg
