nnikolov3/ECE411/Orders and BOM/PCB_arrived3.jpg

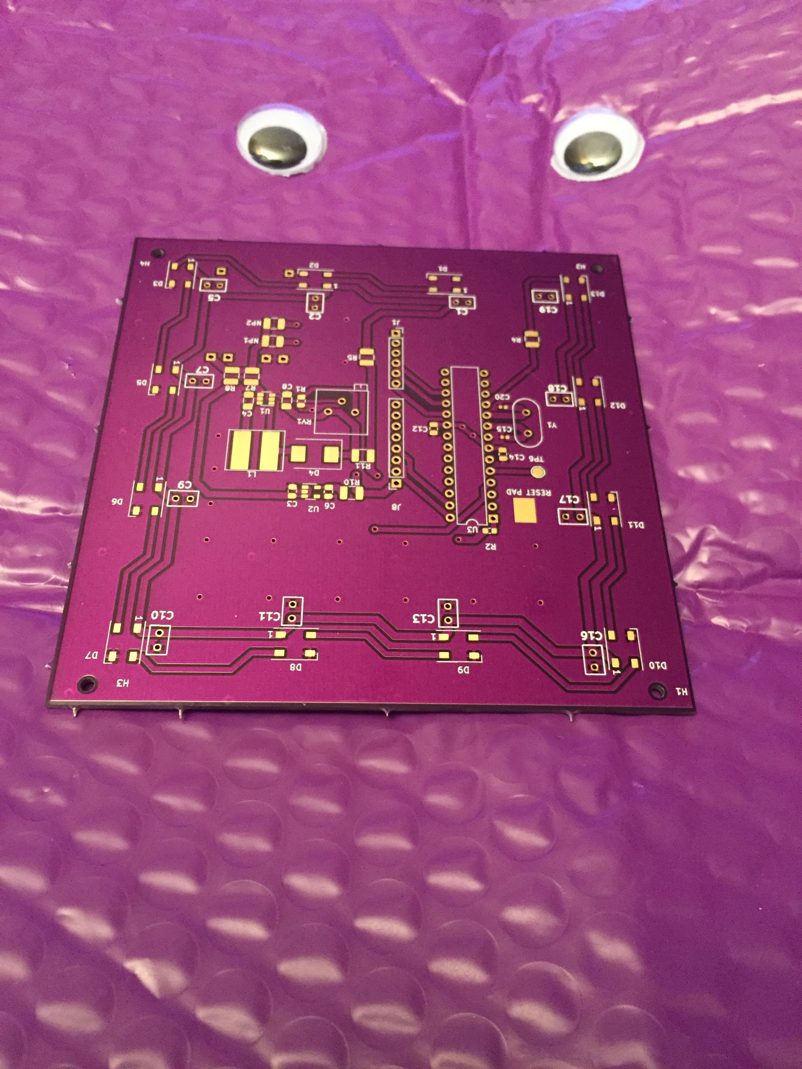
Orders and BOM/PCB_arrived3.jpg
