nnikolov3/ECE411/Orders and BOM/PCB_arrived4.jpg

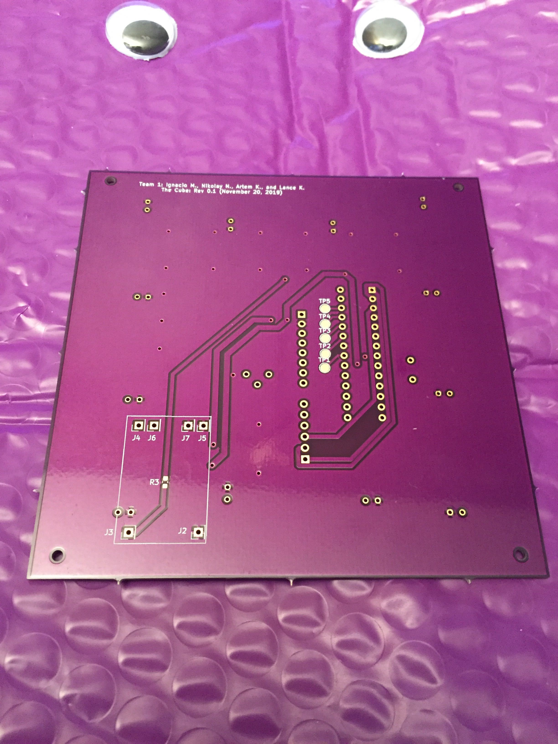
Orders and BOM/PCB_arrived4.jpg
