nnikolov3/ECE411/Orders and BOM/Screen Shot 2019-11-05 at 7.44.17 PM.png

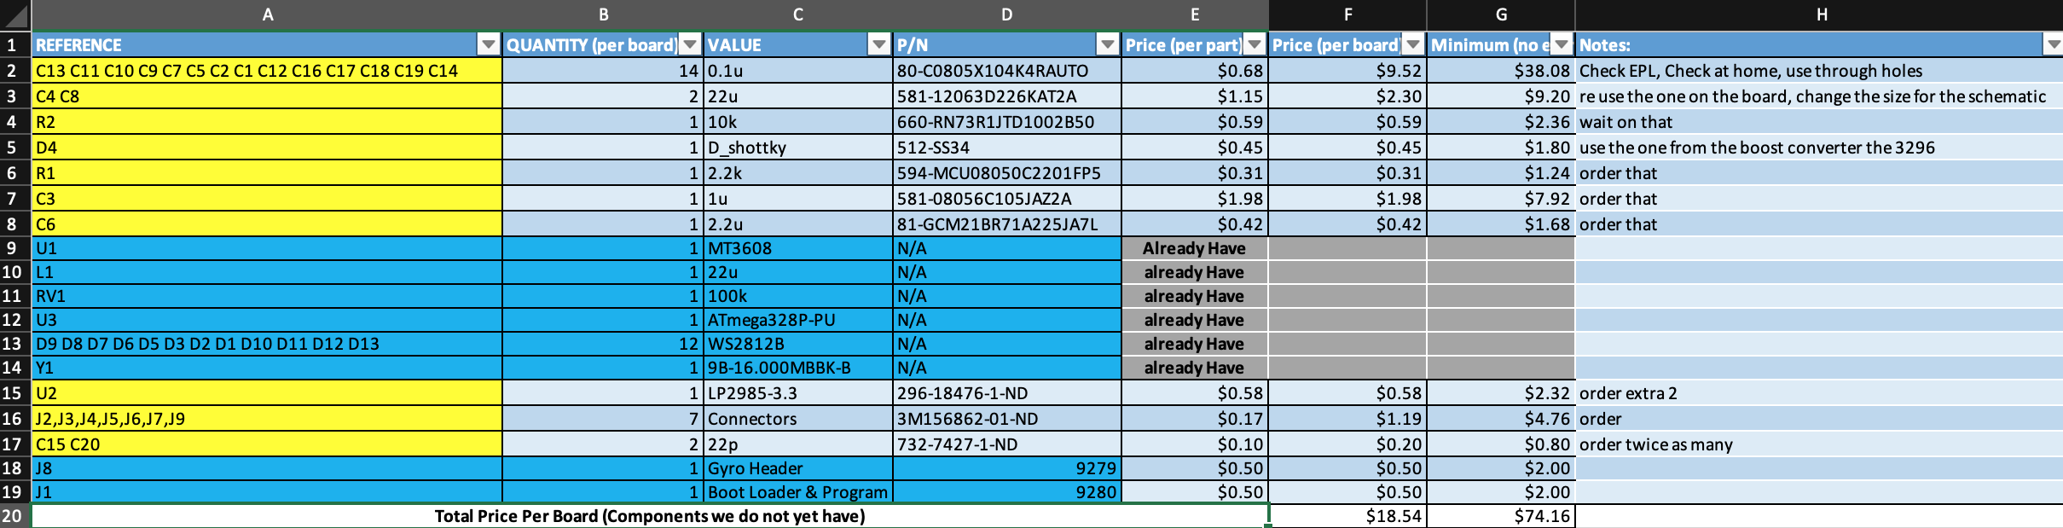
Orders and BOM/Screen Shot 2019-11-05 at 7.44.17 PM.png
