nnikolov3/ECE411/Layout and Schematics/Layout/fit components on the print.jpg

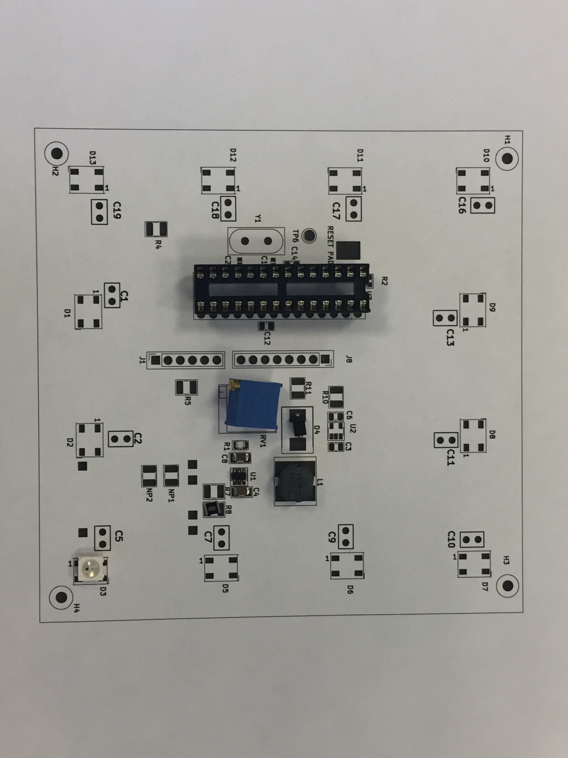
Layout and Schematics/Layout/fit components on the print.jpg
