nnikolov3/ECE411/Pictures_and_Videos/meeting_11_10/artem_making_light_cube_level_1.jpg

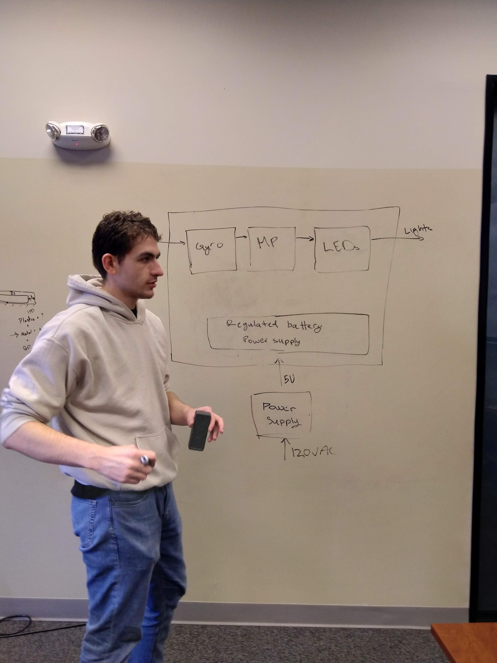
Pictures_and_Videos/meeting_11_10/artem_making_light_cube_level_1.jpg
