nnikolov3/ECE411/Pictures_and_Videos/testing_illumination/PCB_in_cube.jpg

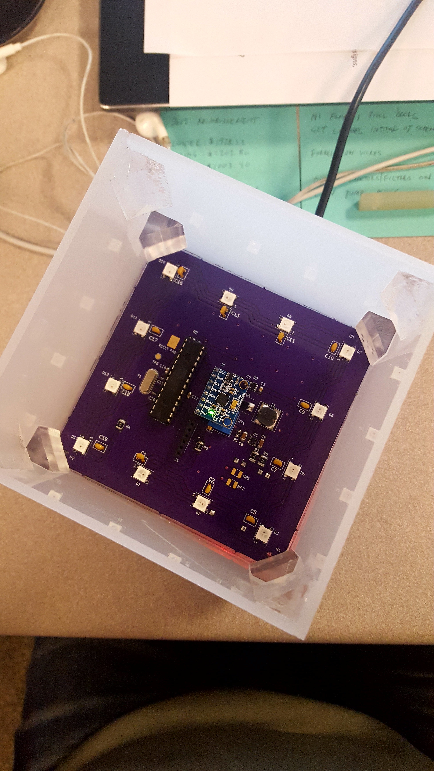
Pictures_and_Videos/testing_illumination/PCB_in_cube.jpg
