nnikolov3/ECE411/Pictures_and_Videos/testing_illumination/test_chargind_station.jpg

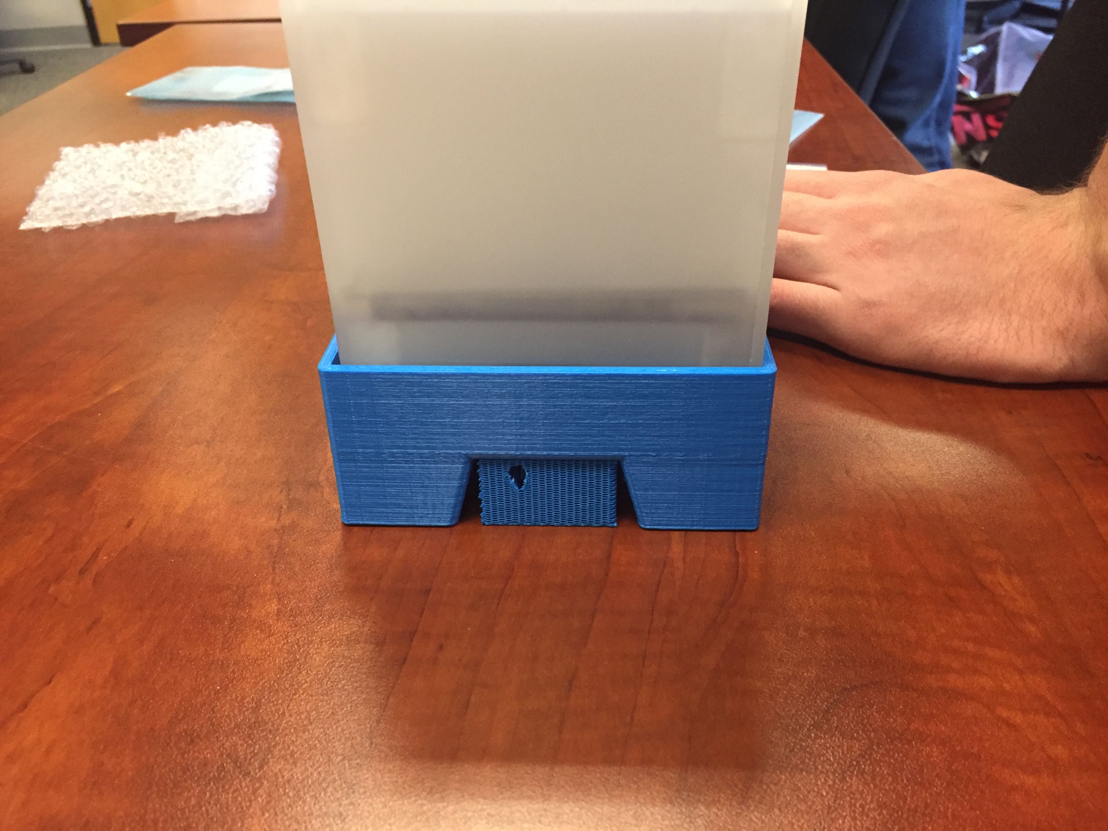
Pictures_and_Videos/testing_illumination/test_chargind_station.jpg
