nnikolov3/ECE411/Pictures_and_Videos/testing_illumination/testing_charging_station.jpg

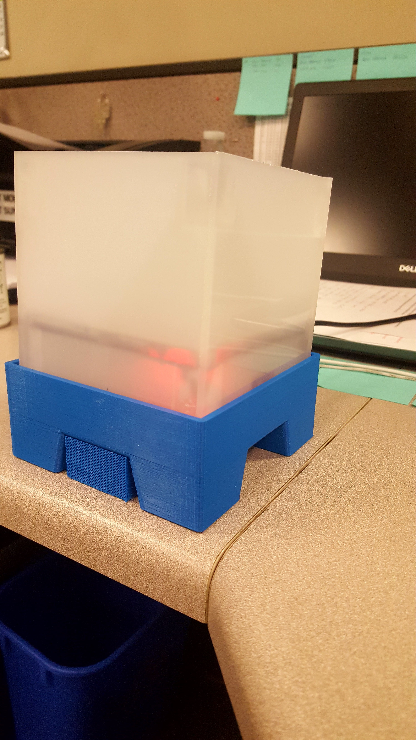
Pictures_and_Videos/testing_illumination/testing_charging_station.jpg
