nnikolov3/ECE411/Layout and Schematics/Schematics/ECE_411_project.pdf

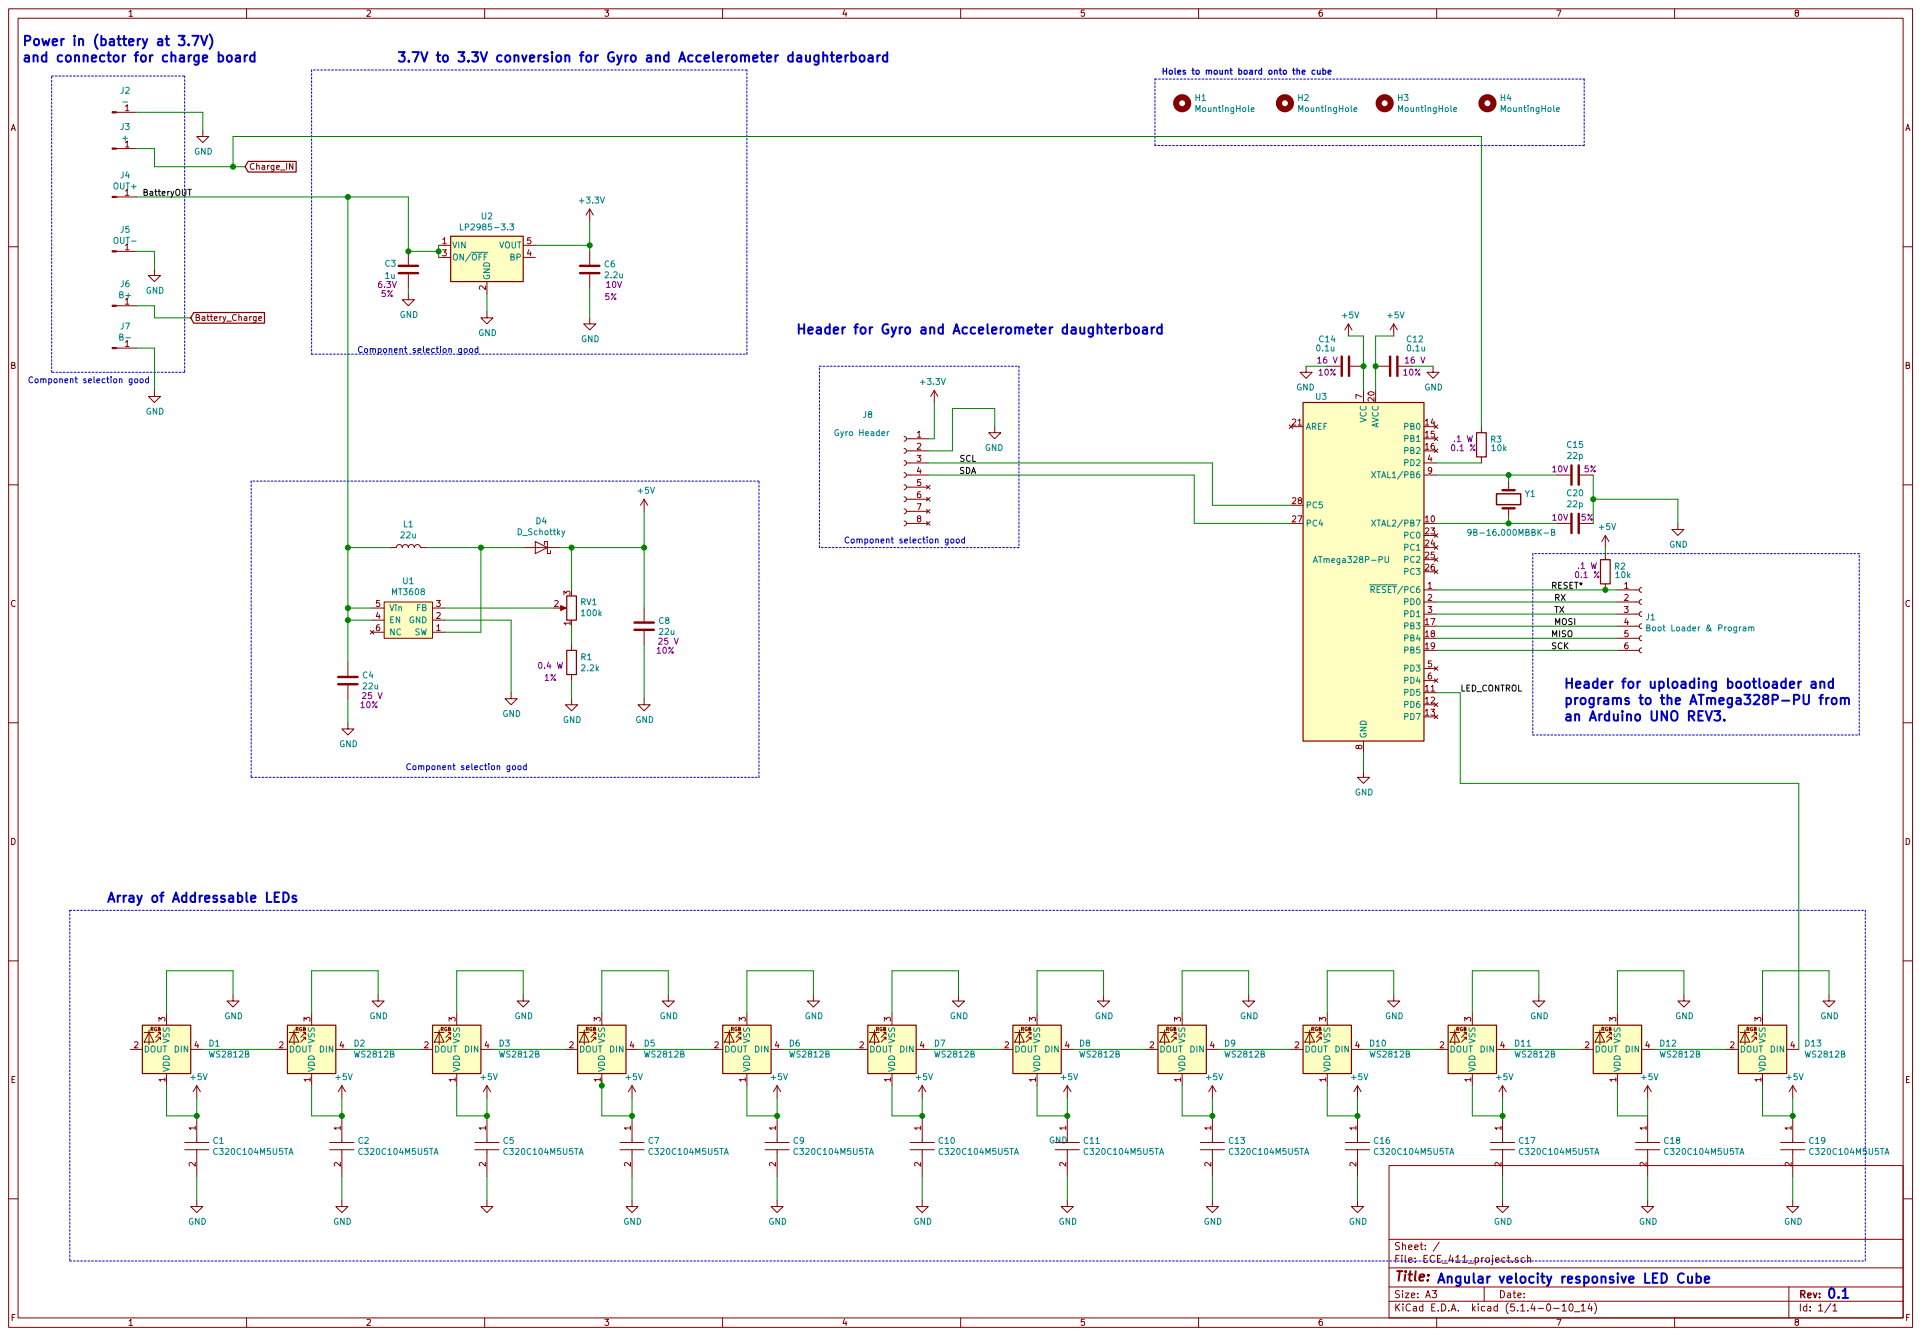
[picture p85: page 1]

Power in (battery at 3.7V)
and connector for charge board

3.7V to 3.3V conversion for Gyro and Accelerometer daughterboard

Holes to mount board onto the cube

2 ON/OFF 3 BP 4 VOUT 5 U2

Header for Gyro and Accelerometer daughterboard

GND
SCK MISO MOSI TXRX RESET* SCL

Header for uploading bootloader and
programs to the ATmega328P-PU from
an Arduino UNO REV3.

Array of Addressable LEDs

Id: 1/1 Title:
Angular velocity responsive LED Cube
