nnikolov3/ECE411/Layout and Schematics/Layout/ECE411_board_FTPrints_front.pdf

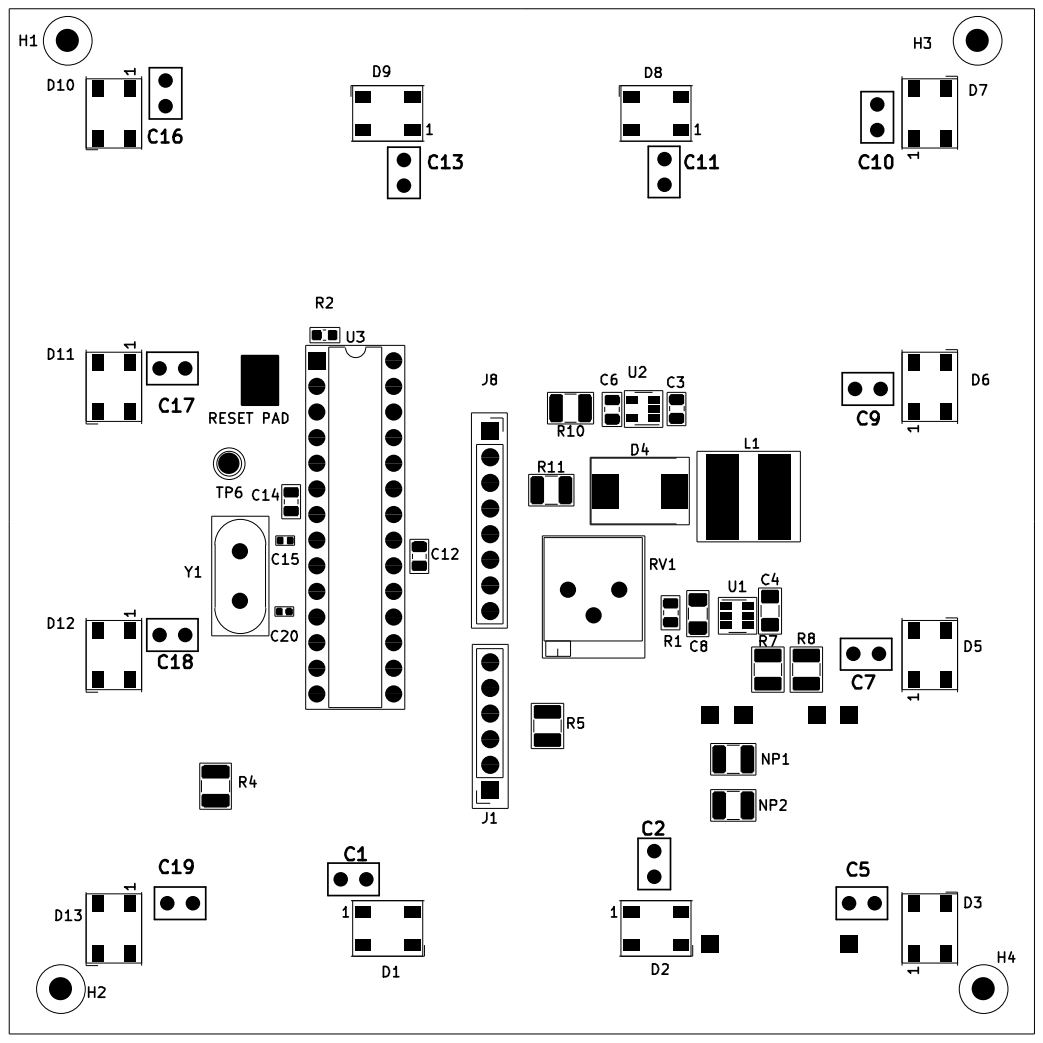
[picture p86: page 1]
