nnikolov3/ECE411/Layout and Schematics/Layout/ECE411_FTP_Front.pdf

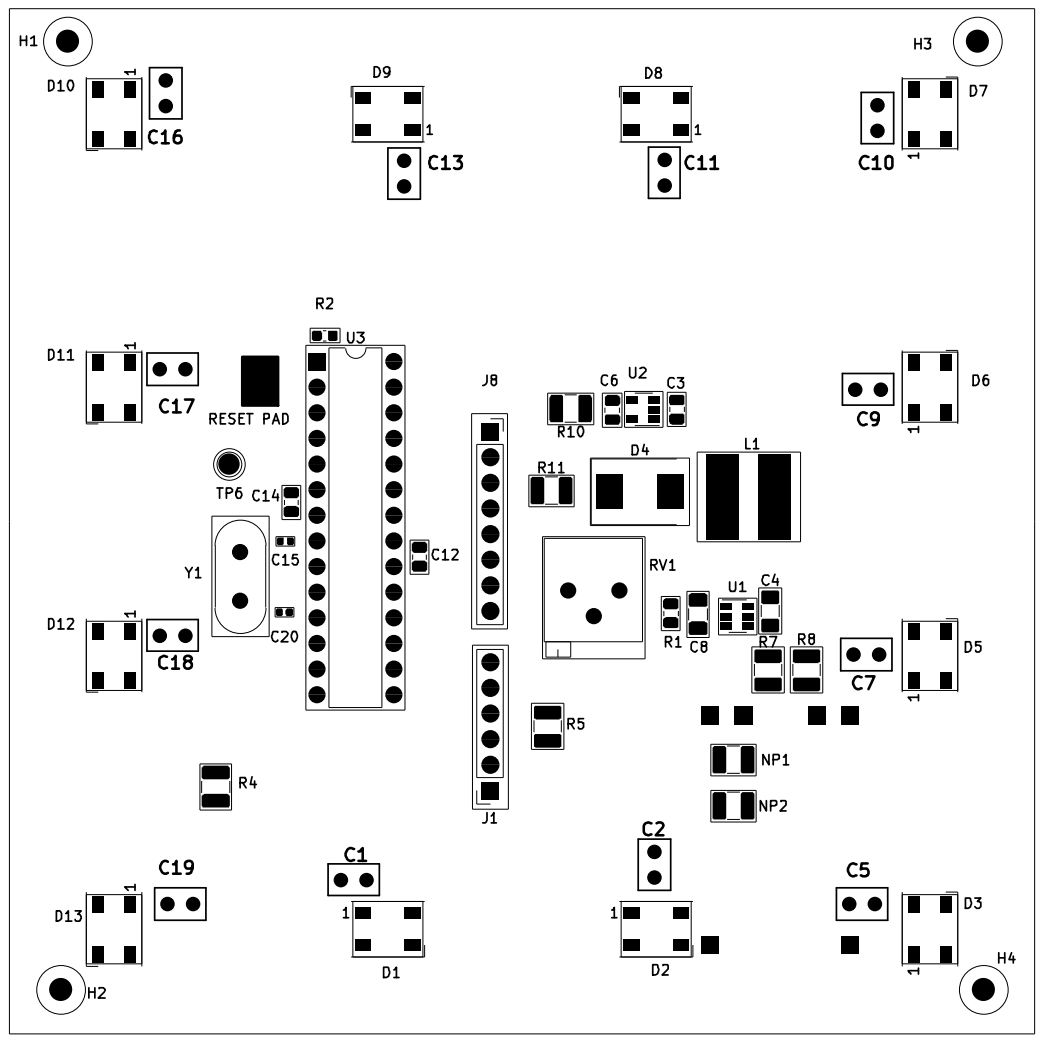
[picture p87: page 1]
