nnikolov3/ECE411/Layout and Schematics/Layout/ECE411_FTprints_back.pdf

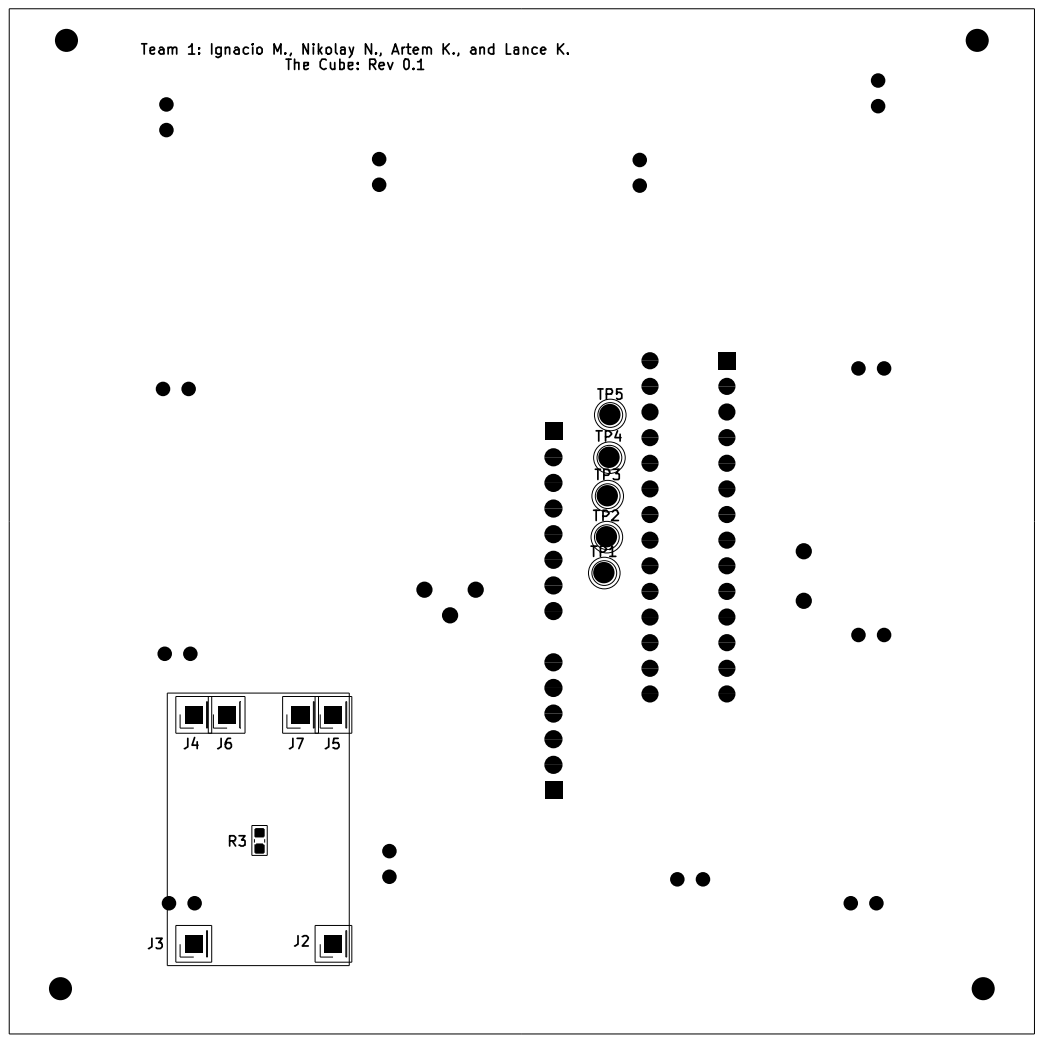
[picture p88: page 1]
