nnikolov3/ECE411/Layout and Schematics/Layout/ECE_411_project-B_Cu.pdf

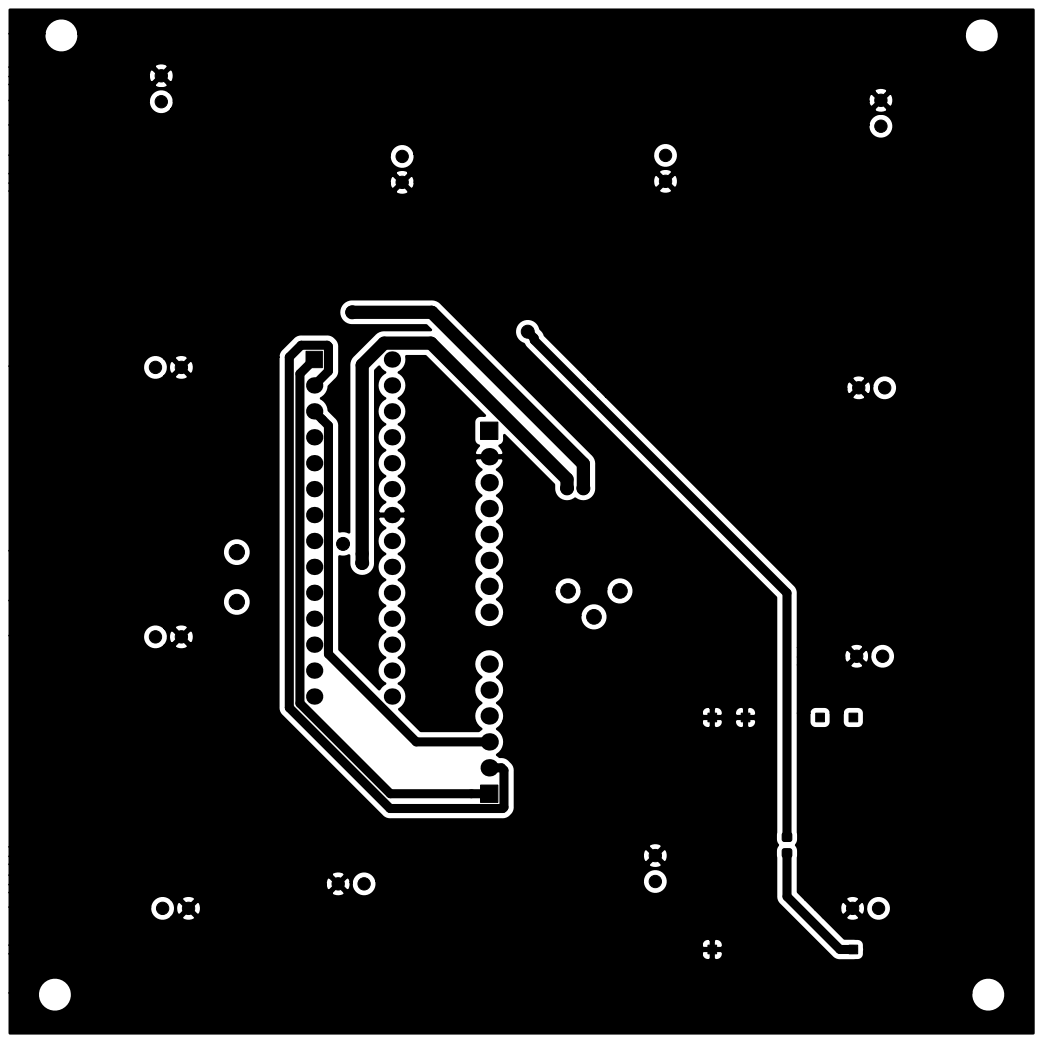
[picture p89: page 1]
