nnikolov3/ECE411/Layout and Schematics/Layout/ECE_411_project-B_Mask.pdf

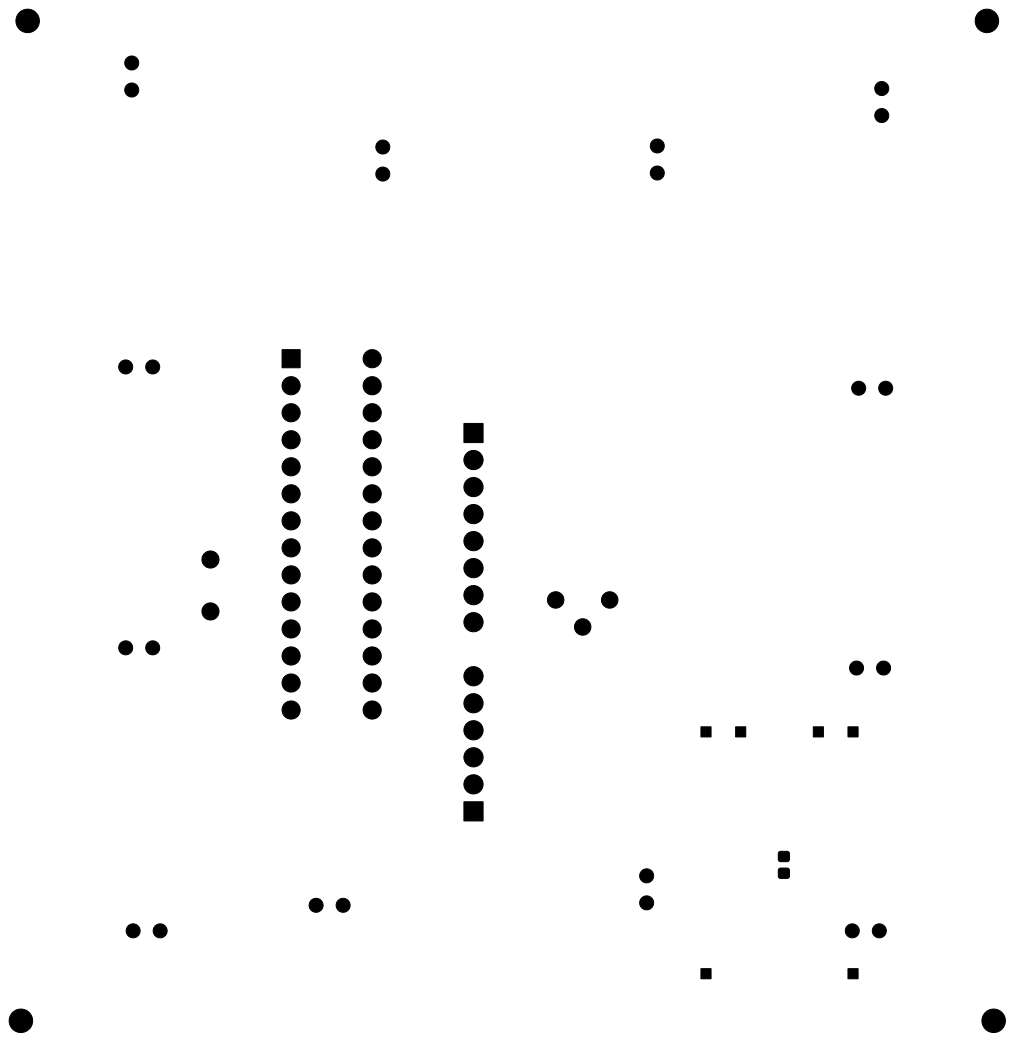
[picture p90: page 1]
