nnikolov3/ECE411/Layout and Schematics/Layout/ECE_411_project-B_SilkS.pdf

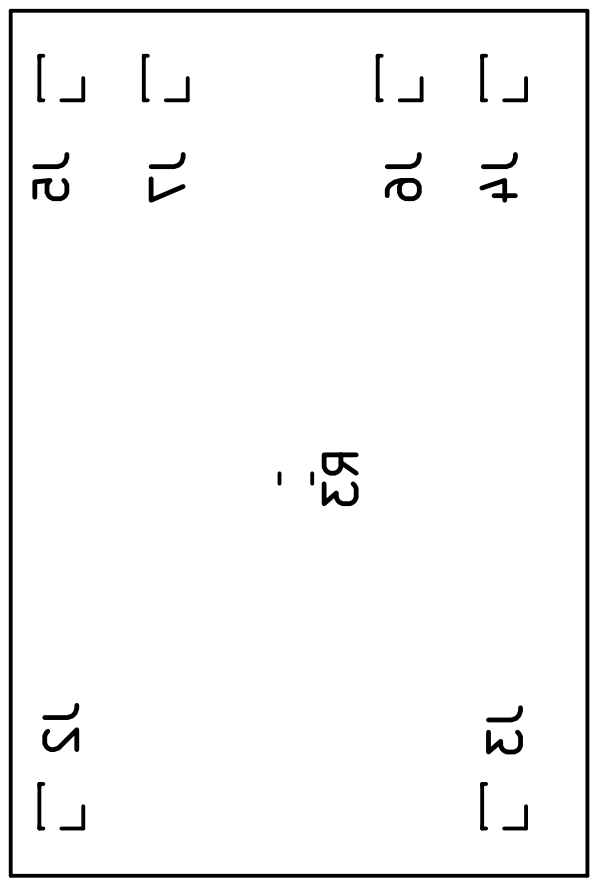
[picture p91: page 1]
