nnikolov3/ECE411/Layout and Schematics/Layout/ECE_411_project-F_Cu.pdf

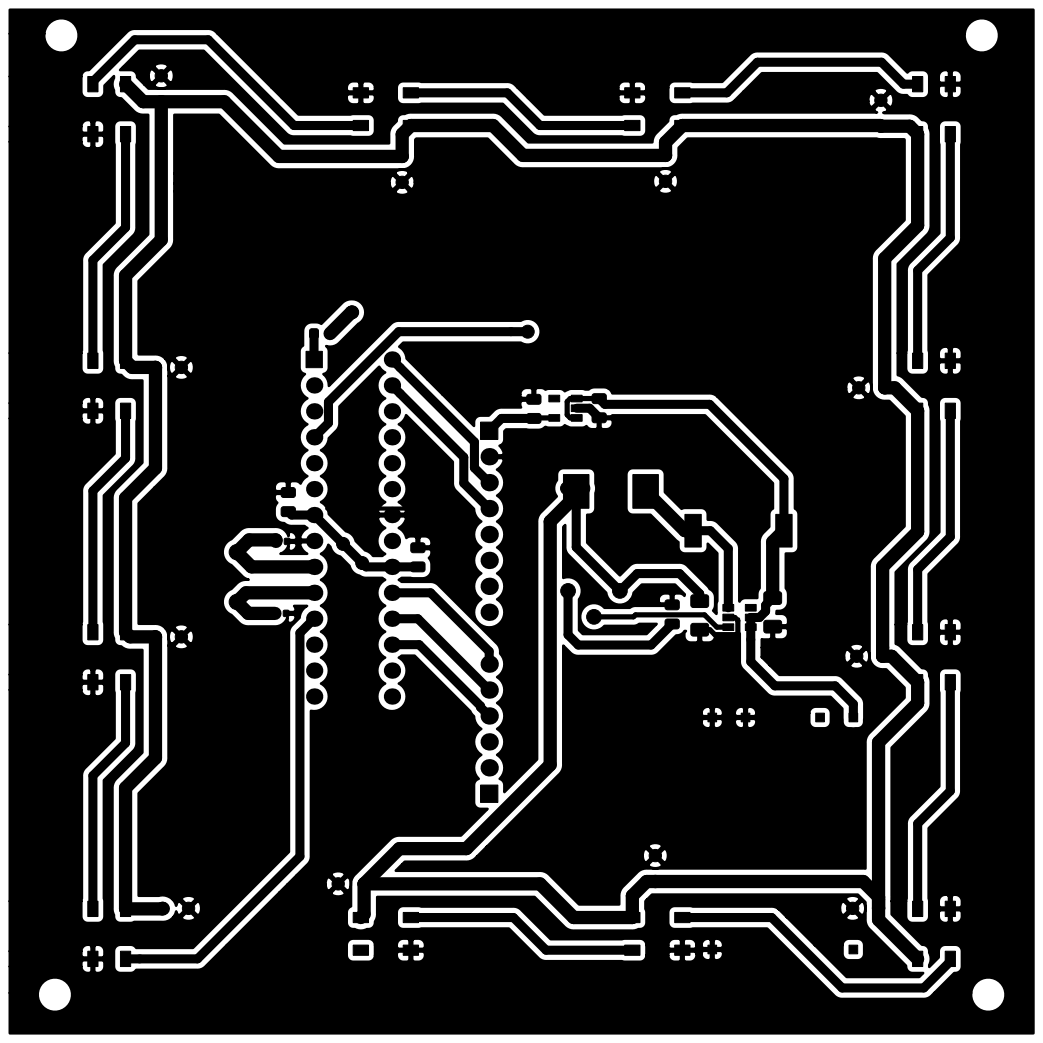
[picture p92: page 1]
