nnikolov3/ECE411/Layout and Schematics/Layout/ECE_411_project-F_Mask.pdf

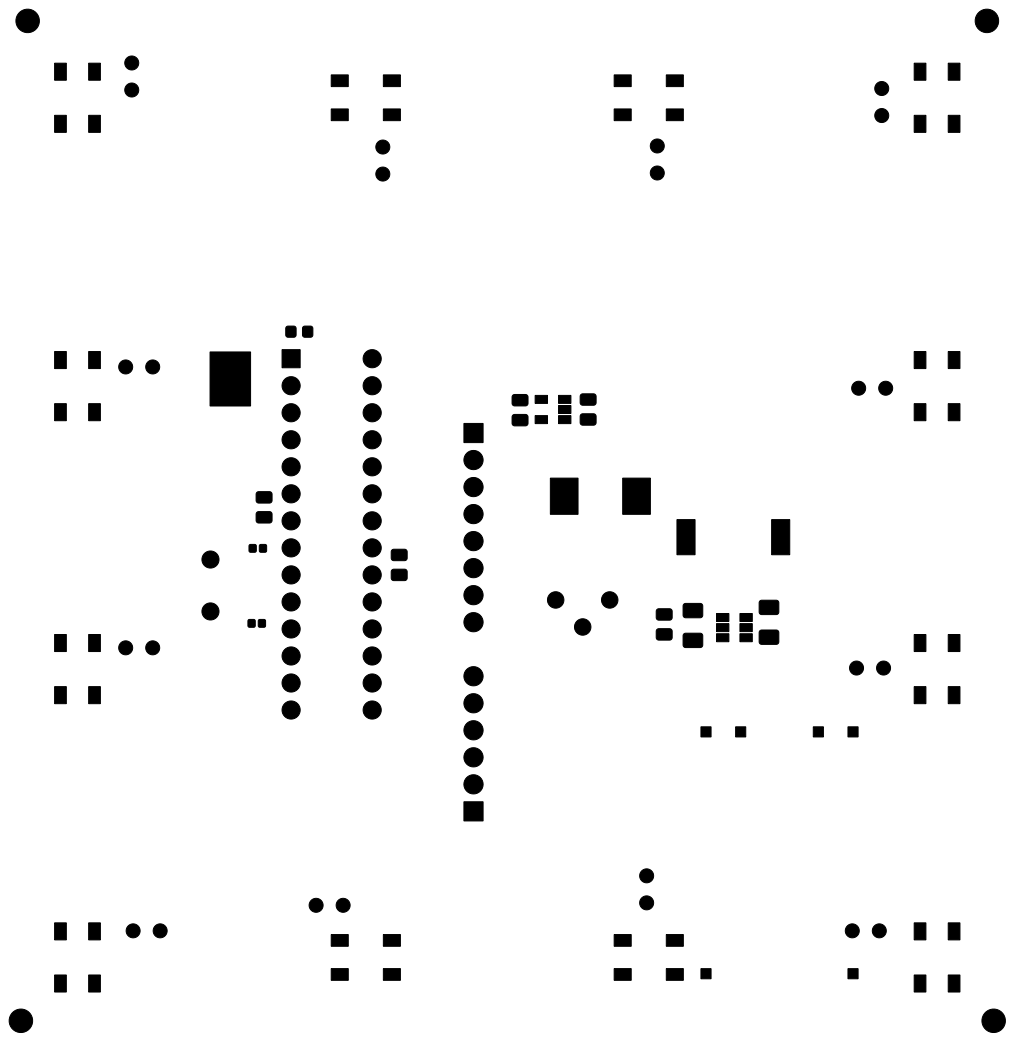
[picture p93: page 1]
