nnikolov3/ECE411/Layout and Schematics/Layout/ECE_411_project-F_Paste.pdf

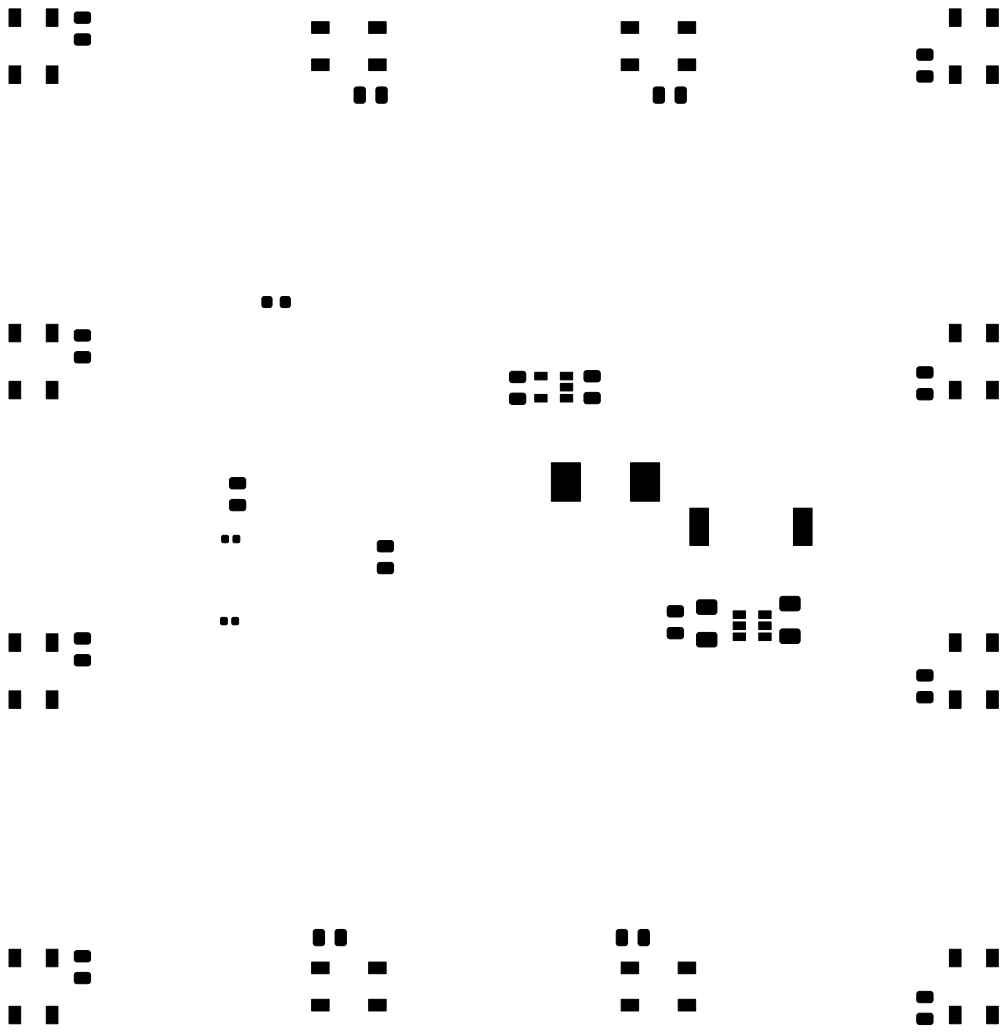
[picture p94: page 1]
