nnikolov3/ECE411/Layout and Schematics/Layout/ECE_411_project-F_SilkS.pdf

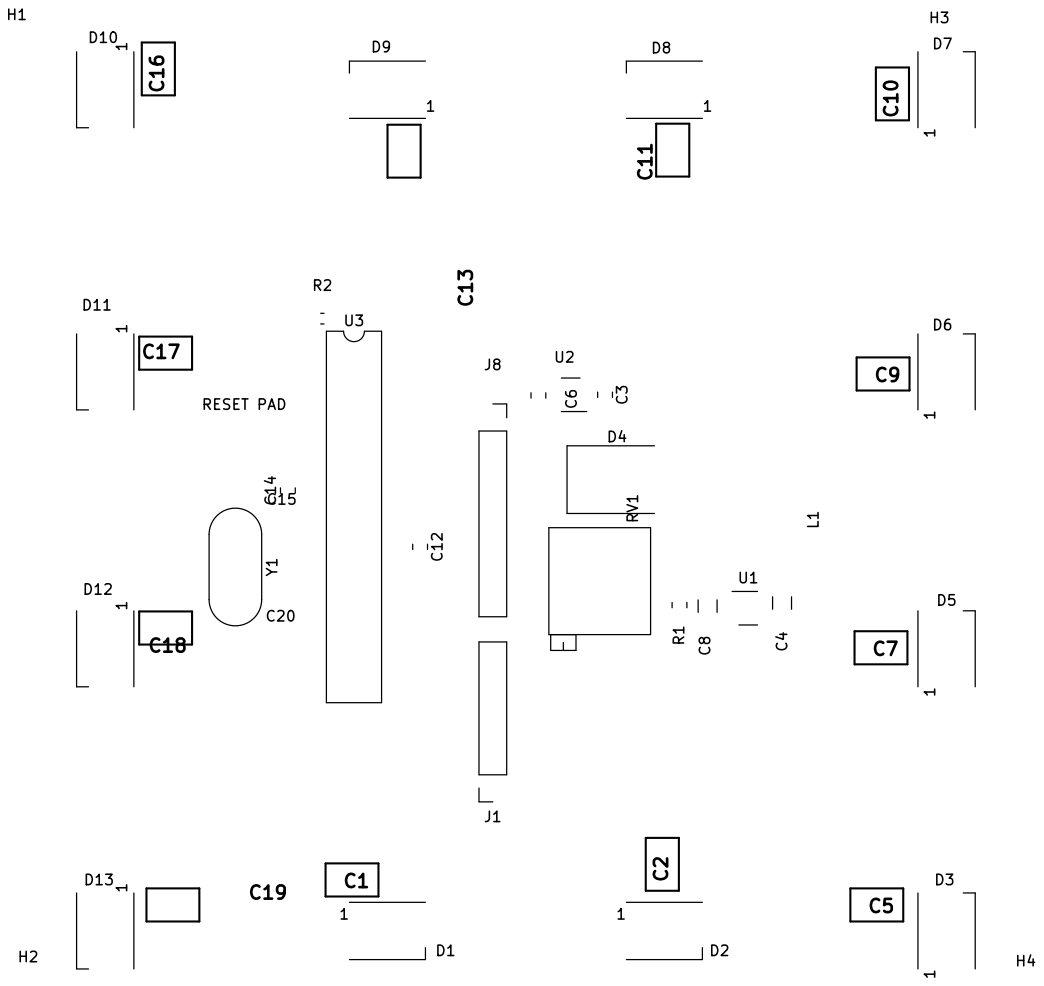
[picture p95: page 1]
