nnikolov3/ECE411/(commit log)

2019-10-17 Testing LED
2019-10-17 testing battery
2019-10-24 first commit of mpu + led demo
2019-10-24 Demo code connecting leds to MPU
2019-10-25 Updated in PDS LED datasheet link
2019-10-25 JPEG Version of schematic
2019-10-27 Using the gyroscope with the ATMega after buring the bootloader
2019-10-27 Adding the pin layout
2019-10-28 Adding Preliminary Schematic
2019-10-28 Addin PNG of the schematic
2019-11-06 Added BOM for cube
2019-11-06 Added some new directories
    [ECE411_BOM_with_meeting_notes.xlsx]
2019-11-06 Screeshot of BOM
2019-11-09 3D model for the charging station
2019-11-14 Layout and Schematics
2019-11-24 Adding pictures for charing station prototype
2019-11-25 added smoothing and orientation LED changs, close to done
2019-11-28 PCB arrived
2019-11-28 more pcb pictures
2019-12-05 Complete Prototype
2019-12-06 Seperated schematics and layouts into two sections, created mechanical section
2019-12-10 Added shake detect, cleaned up logic, fixed aa vs ypr issues, low brightness = 100
    [GyroLEDCode.ino]
2019-12-11 adjusted sensitivity, added extra colors, won't compile
    [GyroLEDCode.ino]
